MrunalSwaroop/deskbot/versions/v0.0.5.4/README.md

# Deskbot v0.0.5.4

**Purpose:** Phone-first dashboard and deferred OTA startup check.

- **Source commit:** `522c56ab17a76cb1aa1095f2c555ba99d42b39a4`
- **Buildable source:** [`source/`](source/)
- **GitHub Release:** [v0.0.5.4](https://github.com/MrunalSwaroop/deskbot/releases/tag/v0.0.5.4)
- **OTA firmware asset:** [v0.0.5.4 binary](https://github.com/MrunalSwaroop/deskbot/releases/download/v0.0.5.4/XIAO-ESP32S3.bin)
- **OTA manifest:** [v0.0.5.4 manifest](https://MrunalSwaroop.github.io/deskbot/releases/0.0.5.4/manifest.json)

The `source/` directory is a historical source snapshot. Build outputs, local `ota_target.h`, Wi-Fi passwords, API keys, and other credentials are intentionally excluded.
