MrunalSwaroop/deskbot/versions/v0.0.5.4/source/modules/audio/README.md

# Audio Module

The current MAX98357A implementation provides the verified I2S initialization and low-volume tone test in `firmware/xiao_esp32s3_sense/xiao_esp32s3_sense.ino`. The next extraction should move PCM playback, tone generation, volume limits, and audio-state events here.

The module must preserve GPIO2/D1 data, GPIO3/D2 BCLK, GPIO4/D3 LRCK, the onboard PDM microphone reservation, and the bridge-tied speaker-output warning.

## v0.0.5.2 loopback boundary

`mic_loopback.h` defines the bounded microphone-to-speaker test policy. The integration sketch owns the I2S objects, applies software volume, and stops loopback automatically. Keep this separate from future decoded speech playback.
