MrunalSwaroop/deskbot/V.0.0.2/legacy/README.md

# Legacy Experiments

This directory contains the historical UNO R4, generic ESP32, laptop bridge, and early face prototypes. They are retained for reference only.

The active Deskbot controller is the XIAO ESP32-S3 Sense firmware under `firmware/xiao_esp32s3_sense/`. Do not include legacy sketches in the active XIAO build or OTA artifact.
