MrunalSwaroop/deskbot/versions/v0.0.1/README.md

# Deskbot v0.0.1

**Purpose:** Frozen XIAO ESP32-S3 Sense hardware baseline.

- **Source commit:** `07578cf026eb161585037c67768f1b4a59ac9450`
- **Buildable source:** [`source/`](source/)
- **GitHub Release:** [v0.0.1](https://github.com/MrunalSwaroop/deskbot/releases/tag/v0.0.1)
- **OTA firmware asset:** [v0.0.1 binary](https://github.com/MrunalSwaroop/deskbot/releases/download/v0.0.1/XIAO-ESP32S3.bin)
- **OTA manifest:** [v0.0.1 manifest](https://MrunalSwaroop.github.io/deskbot/releases/0.0.1/manifest.json)

The `source/` directory is a historical source snapshot. Build outputs, local `ota_target.h`, Wi-Fi passwords, API keys, and other credentials are intentionally excluded.
