MrunalSwaroop/deskbot/versions/v0.0.4/README.md

# Deskbot v0.0.4

**Purpose:** OTA-stable ESP32 Arduino core 3.3.7 baseline.

- **Source commit:** `9120a983b3ed8a17bfb8108c6694ef7dbb7d3194`
- **Buildable source:** [`source/`](source/)
- **GitHub Release:** [v0.0.4](https://github.com/MrunalSwaroop/deskbot/releases/tag/v0.0.4)
- **OTA firmware asset:** [v0.0.4 binary](https://github.com/MrunalSwaroop/deskbot/releases/download/v0.0.4/XIAO-ESP32S3.bin)
- **OTA manifest:** [v0.0.4 manifest](https://MrunalSwaroop.github.io/deskbot/releases/0.0.4/manifest.json)

The `source/` directory is a historical source snapshot. Build outputs, local `ota_target.h`, Wi-Fi passwords, API keys, and other credentials are intentionally excluded.
