MrunalSwaroop/deskbot/versions/v0.0.5.1/README.md

# Deskbot v0.0.5.1

**Purpose:** OLED inversion and OTA state/progress UI.

- **Source commit:** `f95edb852325a56a45b004a5ab532f8c2b33f6a1`
- **Buildable source:** [`source/`](source/)
- **GitHub Release:** [v0.0.5.1](https://github.com/MrunalSwaroop/deskbot/releases/tag/v0.0.5.1)
- **OTA firmware asset:** [v0.0.5.1 binary](https://github.com/MrunalSwaroop/deskbot/releases/download/v0.0.5.1/XIAO-ESP32S3.bin)
- **OTA manifest:** [v0.0.5.1 manifest](https://MrunalSwaroop.github.io/deskbot/releases/0.0.5.1/manifest.json)

The `source/` directory is a historical source snapshot. Build outputs, local `ota_target.h`, Wi-Fi passwords, API keys, and other credentials are intentionally excluded.
