MrunalSwaroop/deskbot/versions/v0.0.5.2/README.md

# Deskbot v0.0.5.2

**Purpose:** Microphone loopback, speaker volume, and wake-name boundary.

- **Source commit:** `c314447c3eacd343f680d7743e713bf62445ca13`
- **Buildable source:** [`source/`](source/)
- **GitHub Release:** [v0.0.5.2](https://github.com/MrunalSwaroop/deskbot/releases/tag/v0.0.5.2)
- **OTA firmware asset:** [v0.0.5.2 binary](https://github.com/MrunalSwaroop/deskbot/releases/download/v0.0.5.2/XIAO-ESP32S3.bin)
- **OTA manifest:** [v0.0.5.2 manifest](https://MrunalSwaroop.github.io/deskbot/releases/0.0.5.2/manifest.json)

The `source/` directory is a historical source snapshot. Build outputs, local `ota_target.h`, Wi-Fi passwords, API keys, and other credentials are intentionally excluded.
