MrunalSwaroop/deskbot/versions/v0.0.5.3/README.md

# Deskbot v0.0.5.3

**Purpose:** Dual Wi-Fi, setup fallback, remote OLED, and versioned OTA catalog.

- **Source commit:** `5d226d0db5bbb8b0b62f9164e7e145dcdf0be262`
- **Buildable source:** [`source/`](source/)
- **GitHub Release:** [v0.0.5.3](https://github.com/MrunalSwaroop/deskbot/releases/tag/v0.0.5.3)
- **OTA firmware asset:** [v0.0.5.3 binary](https://github.com/MrunalSwaroop/deskbot/releases/download/v0.0.5.3/XIAO-ESP32S3.bin)
- **OTA manifest:** [v0.0.5.3 manifest](https://MrunalSwaroop.github.io/deskbot/releases/0.0.5.3/manifest.json)

The `source/` directory is a historical source snapshot. Build outputs, local `ota_target.h`, Wi-Fi passwords, API keys, and other credentials are intentionally excluded.
