MrunalSwaroop/deskbot/versions/v0.0.5.4/source/hardware/wiring/assembly_layout.png

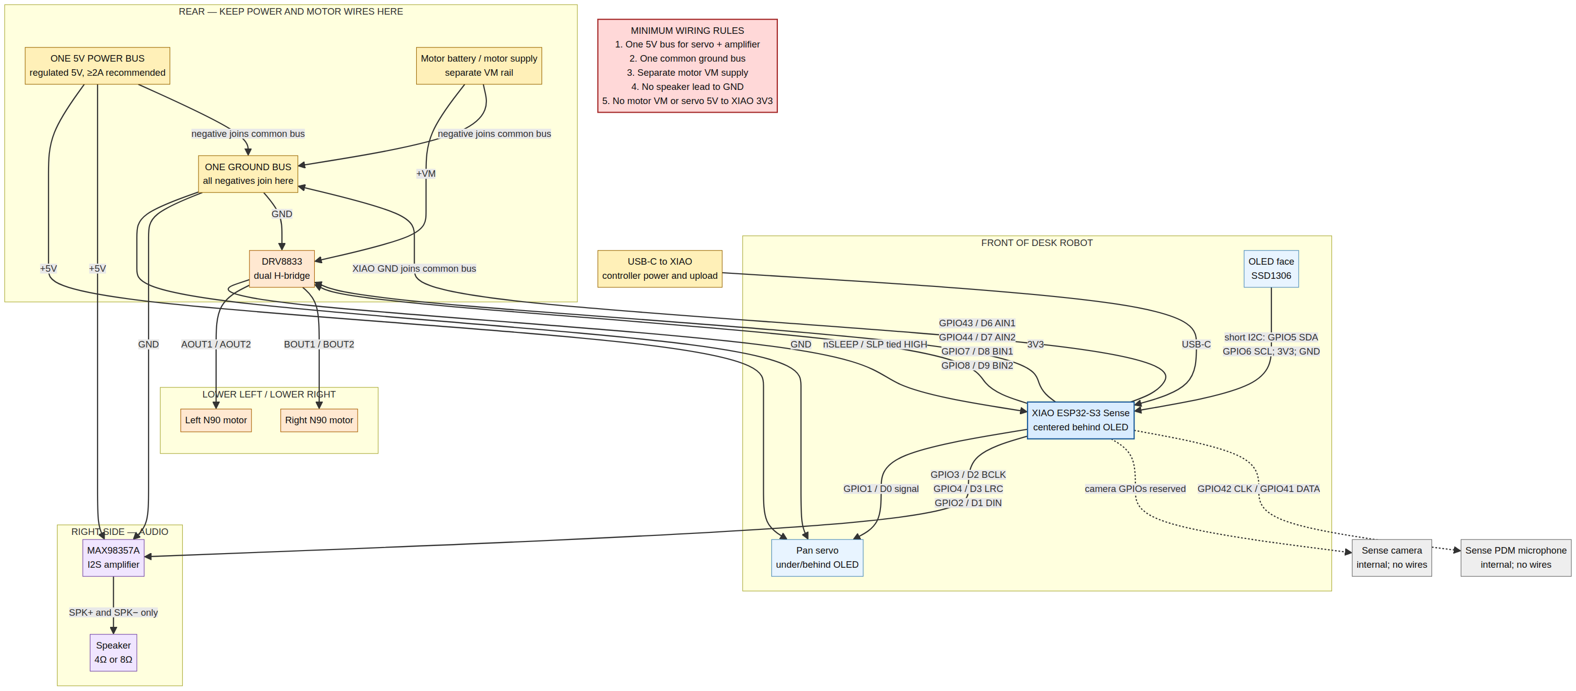
versions/v0.0.5.4/source/hardware/wiring/assembly_layout.png
