MrunalSwaroop/deskbot/versions/v0.0.5.4/source/hardware/wiring/complete_wiring.png

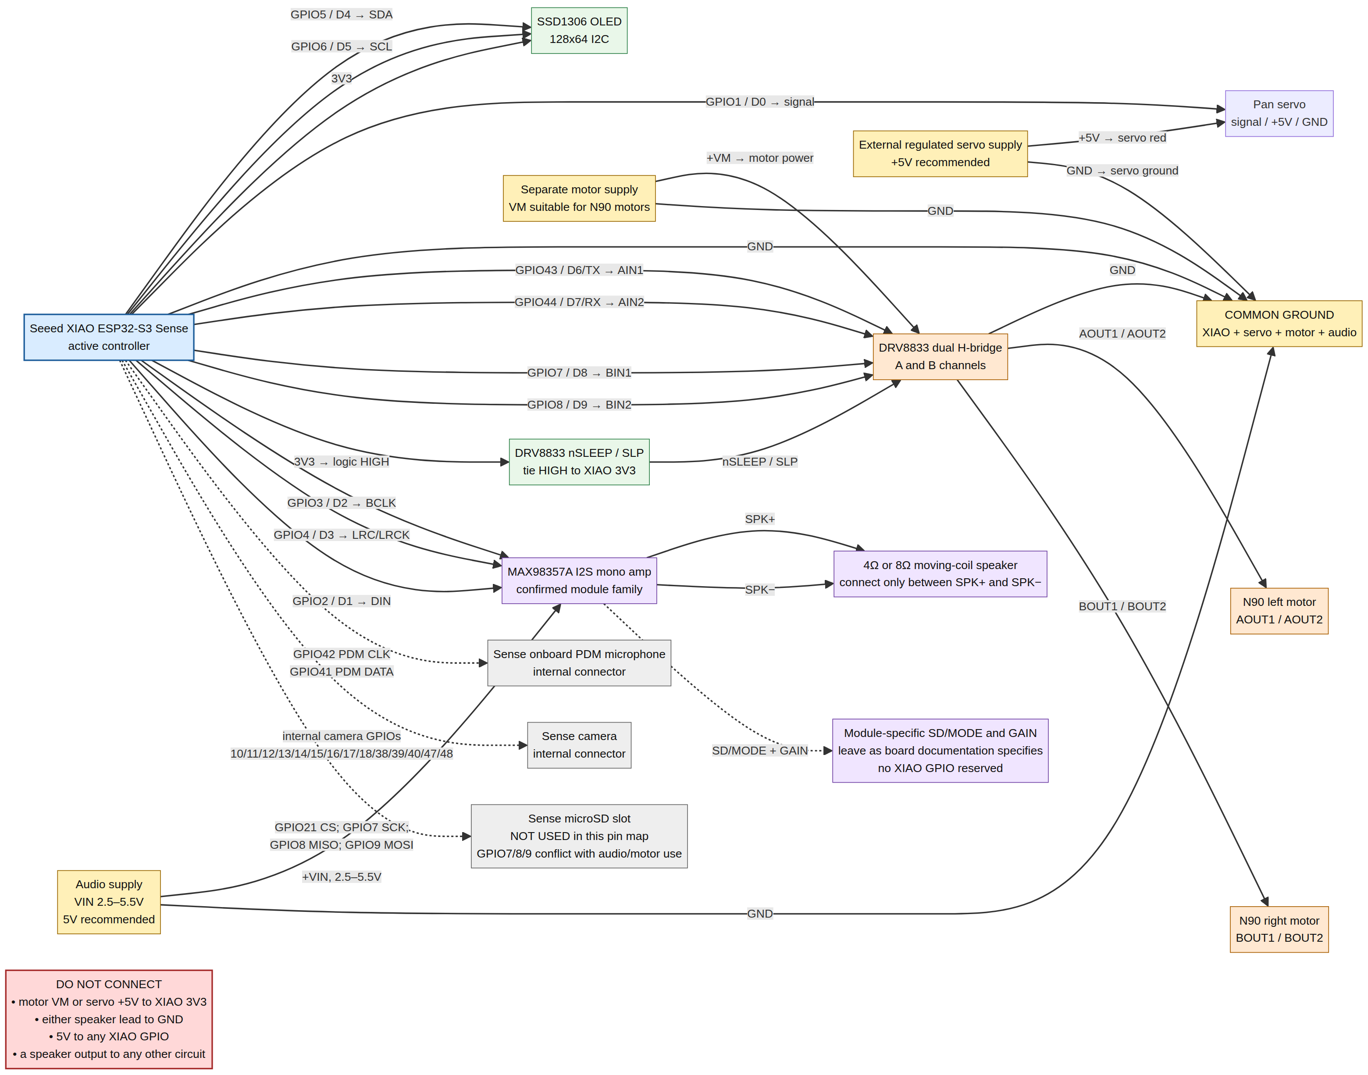
versions/v0.0.5.4/source/hardware/wiring/complete_wiring.png
