MrunalSwaroop/deskbot/versions/v0.0.5.4/source/firmware/xiao_esp32s3_sense/xiao_esp32s3_sense.ino

#include <WiFi.h>
#include <WebServer.h>
#include <Preferences.h>
#include <Wire.h>
#include <Adafruit_GFX.h>
#include <Adafruit_SSD1306.h>
#include <ESP32Servo.h>
#include <ESP_I2S.h>
#include <time.h>
#include <esp_camera.h>
#include "../../boards/xiao-esp32s3-sense/pinmap.h"
#include "device_config.h"
#include "ota_service.h"
#include "../../modules/core/face_state.h"
#include "../../modules/core/personality.h"
#include "../../modules/audio/mic_loopback.h"
#include "../../modules/voice/wake_name.h"
#include "../../modules/network/wifi_profiles.h"
#include "../../modules/ota/version_catalog.h"
#include "../../modules/core/release_notes.h"

/*
  Rocky XIAO Desk Buddy - modular Stage 2 bring-up

  This firmware is intentionally a hardware bring-up base, not the final voice
  firmware. It tests one function at a time:
    OLED -> servo -> DRV8833/N90 motors -> Wi-Fi/dashboard.

  Hardware-specific choices live in boards/xiao-esp32s3-sense/pinmap.h. No Wi-Fi password or API key
  is compiled into this sketch; Wi-Fi is provisioned through the setup AP.

  DRV8833 control model:
    AIN1/AIN2 control the left motor; BIN1/BIN2 control the right motor.
    PWM is applied directly to the selected input and the opposite input is LOW.
    nSLEEP/SLP must be tied to XIAO 3V3. nFAULT is optional and not used here.
*/

#define SCREEN_WIDTH 128
#define SCREEN_HEIGHT 64

Adafruit_SSD1306 display(SCREEN_WIDTH, SCREEN_HEIGHT, &Wire, -1);
#include "../../modules/faces/isabella_character.h"
#include "../../modules/faces/spartan_character.h"
#include "../../modules/faces/rocky_body_language.h"
namespace RockyBodyLanguage {
Adafruit_SSD1306 &display = ::display;
}
WebServer server(80);
Preferences preferences;
Servo headServo;
I2SClass microphone;
I2SClass audioOutput;
OtaService otaService;

// ------------------------------ State ------------------------------

FaceMode faceMode = FACE_IDLE;
Personality personality = PERSONALITY_CALM;
int panAngle = 90;
int motorSpeed = ROCKY_DEFAULT_MOTOR_SPEED;
String lastEvent = "Booting";
String lastCommand = "none";
String savedSsid;
String savedPassword;
String savedSsid2;
String savedPassword2;
WifiProfile wifiProfiles[2];
int activeWifiIndex = -1;

bool provisioningAP = false;
unsigned long lastWiFiAttempt = 0;
unsigned long wifiUnavailableSince = 0;
unsigned long apStartedAt = 0;
const unsigned long WIFI_FALLBACK_AP_AFTER_MS = 300000UL;
unsigned long lastMotorCommand = 0;
unsigned long lastFaceFrame = 0;
unsigned long faceFrame = 0;
unsigned long nextIsabellaMoodAt = 0;
FaceMode isabellaMood = FACE_IDLE;
bool importedCharacterStateOverride = false;
bool cameraReady = false;
bool cameraBusy = false;
bool microphoneReady = false;
bool microphoneMonitor = false;
bool microphoneLoopback = false;
bool audioReady = false;
bool audioToneActive = false;
bool headFollowsState = true;
bool danceActive = false;
bool liveCameraActive = false;
bool oledInverted = false;
String otaUiState = "idle";
int otaUiProgress = 0;
bool rockyCharacterStateOverride = false;
bool leftMotorInvert = ROCKY_LEFT_MOTOR_INVERT;
bool rightMotorInvert = ROCKY_RIGHT_MOTOR_INVERT;
unsigned long microphoneMonitorUntil = 0;
unsigned long microphoneLoopbackUntil = 0;
unsigned long lastMicRead = 0;
unsigned long lastMicPrint = 0;
int microphoneLevel = 0;
int speakerVolume = 20;
String wakeName = "rocky";
bool wakeNameEnabled = true;
bool wakeNameEngaged = false;
unsigned long wakeEngagedUntil = 0;
unsigned long audioToneUntil = 0;
uint32_t audioTonePhase = 0;
uint32_t audioTonePhaseStep = 0;
int audioToneFrequency = 440;
int danceStep = 0;
unsigned long danceStepStarted = 0;

// ------------------------------ Declarations ------------------------------

void drawFace();
void syncImportedCharacterState();
bool drawImportedCharacter();
void drawEyes(int eyeY, int eyeH, bool narrow, bool round, bool lookingLeft, bool lookingRight);
void drawMouth();
void drawWiFiIndicator();
void drawOtaIndicator();
void onOtaUiEvent(const char *state, int progress);
void setOledInverted(bool enabled, const String &reason);
void drawPersonalityAccent();
void updateIsabellaMood();
void updateMicrophone();
void updateAudioTone();
void startMicLoopback(uint32_t durationMs);
void stopMicLoopback(const String &reason);
void setSpeakerVolume(int percent);
void engageWakeName(const String &source);
void drawMicIndicator();
void updateDance();
void applyStateHeadPose();
void startDance();
void stopDance(const String &reason);
void setFace(FaceMode mode, const String &eventText);
void setPersonality(const String &name);
void processSerialCommand(const String &command);
void runTest(const String &name);
void runMotorChannelTest(const String &side);
void setPan(int angle);
void stopMotors(const String &reason);
void driveMotors(const String &direction, int speed, uint32_t durationMs);
void setMotorChannel(int in1, int in2, int signedPwm, bool invert);
void startAccessPoint();
void connectStoredWiFi();
bool tryWiFiProfiles();
void maintainWiFi();
void setupRoutes();
void handleRoot();
void handleHealth();
void handleStatus();
void handleChanges();
void handleCommand();
void handleOledSvg();
void handleOtaCatalog();
void handleCameraJpg();
void handleCameraLive();
void handleWiFiForm();
void handleWiFiSave();
void handleNotFound();
String pageHeader(const String &title);
String htmlEscape(const String &value);
String faceName();
String personalityName();
String networkModeName();
String currentTimeText();
String motorDriverName();
String cameraStatusName();
bool initCamera();
bool initMicrophone();
String microphoneStatusName();
bool initAudio();
String audioStatusName();
void startAudioTone(int frequency, uint32_t durationMs);
void stopAudio(const String &reason);

// ------------------------------ Setup/loop ------------------------------

void setup() {
  Serial.begin(115200);
  delay(500);
  randomSeed((uint32_t)micros());

  Wire.begin(ROCKY_OLED_SDA, ROCKY_OLED_SCL);
  if (!display.begin(SSD1306_SWITCHCAPVCC, ROCKY_OLED_ADDRESS)) {
    Serial.println("OLED ERROR: check VCC/GND, SDA/SCL, address 0x3C or 0x3D");
  } else {
    display.clearDisplay();
    display.setTextColor(SSD1306_WHITE);
    display.setTextSize(1);
    display.setCursor(8, 20);
    display.println("Rocky XIAO booting");
    display.display();
  }

  // Servo signal only: use an external regulated 5 V servo supply and common GND.
  headServo.setPeriodHertz(50);
  headServo.attach(ROCKY_SERVO_PIN, 500, 2400);
  setPan(90);

  // DRV8833 has no separate enable pins. All four input pins are outputs.
  pinMode(ROCKY_LEFT_IN1, OUTPUT);
  pinMode(ROCKY_LEFT_IN2, OUTPUT);
  pinMode(ROCKY_RIGHT_IN1, OUTPUT);
  pinMode(ROCKY_RIGHT_IN2, OUTPUT);
  stopMotors("Boot safety stop");

  cameraReady = initCamera();
  microphoneReady = initMicrophone();
  audioReady = initAudio();

  preferences.begin("rocky-xiao", false);
  savedSsid = preferences.getString("ssid", "");
  savedPassword = preferences.getString("pass", "");
  savedSsid2 = preferences.getString("ssid2", "");
  savedPassword2 = preferences.getString("pass2", "");
  wifiProfiles[0] = {savedSsid, savedPassword};
  wifiProfiles[1] = {savedSsid2, savedPassword2};
  leftMotorInvert = preferences.getBool("leftInv", ROCKY_LEFT_MOTOR_INVERT);
  rightMotorInvert = preferences.getBool("rightInv", ROCKY_RIGHT_MOTOR_INVERT);
  oledInverted = preferences.getBool("oledInv", false);
  speakerVolume = constrain((int)preferences.getUChar("spkVol", 20), 0, 100);
  wakeName = preferences.getString("wakeName", "rocky");
  if (wakeName.length() == 0) wakeName = "rocky";
  wakeNameEnabled = preferences.getBool("wakeEnabled", true);
  display.invertDisplay(oledInverted);

  setupRoutes();
  // Network must exist before WebServer::begin() on recent ESP32 cores.
  connectStoredWiFi();
  server.begin();
  configTime(ROCKY_DEFAULT_TIMEZONE_OFFSET_SECONDS, 0, "pool.ntp.org", "time.nist.gov");
  otaService.setUiCallback(onOtaUiEvent);
  otaService.begin();

  setFace(FACE_IDLE, "Ready");
  nextIsabellaMoodAt = millis() + ROCKY_ISABELLA_MOOD_MIN_MS;

  Serial.println();
  Serial.println("Rocky XIAO modular bring-up ready");
  Serial.println("Hardware config: boards/xiao-esp32s3-sense/pinmap.h");
  Serial.println("Driver: DRV8833 direct-input PWM");
  Serial.println("Commands: help, status, test oled/servo/motor/left/right/wifi/camera/mic/audio");
  Serial.println("          face idle/listening/thinking/working/speaking/happy/laugh/curious/sad/surprised/error/sleep");
  Serial.println("          personality calm/rocky/engineer/spartan/isabella");
  Serial.println("          isabella neutral/shy/happy/concerned/listening/speaking/sleeping");
  Serial.println("          spartan guard/command/salute/listening/thinking/laughing/march/attack/victory/sleeping");
  Serial.println("          pan 0..180, head auto/on/off, motor forward/back/left/right/test/stop");
  Serial.println("          motor speed 0..255, motor invert left/right on/off, dance start/stop, mic monitor");
  Serial.println("          audio tone [Hz] [ms], audio volume 0..100, audio stop");
  Serial.println("          mic loopback [seconds], mic monitor, mic off");
  Serial.println("          wake name <name>, wake on/off, wake simulate");
  Serial.println("          oled invert on/off/toggle");
  Serial.println("          wifi profiles: two saved 2.4 GHz networks; AP fallback after 5 minutes");
  Serial.println("          ota latest | ota target <version> | ota clear");
}

void loop() {
  server.handleClient();
  maintainWiFi();
  otaService.update();

  if (millis() - lastMotorCommand > ROCKY_MOTOR_COMMAND_TIMEOUT_MS) {
    stopMotors("Motor timeout safety stop");
  }

  if (personality == PERSONALITY_ISABELLA) updateIsabellaMood();
  updateMicrophone();
  updateAudioTone();
  if (wakeNameEngaged && millis() >= wakeEngagedUntil) {
    wakeNameEngaged = false;
    if (!microphoneLoopback && faceMode == FACE_LISTENING) setFace(FACE_IDLE, "Wake interaction timeout");
  }
  updateDance();

  if (millis() - lastFaceFrame >= ROCKY_FACE_FRAME_MS) {
    lastFaceFrame = millis();
    faceFrame++;
    if (personality == PERSONALITY_ROCKY) RockyBodyLanguage::tickIntegration(millis());
    drawFace();
  }

  if (Serial.available()) {
    String command = Serial.readStringUntil('\n');
    command.trim();
    if (command.length() > 0) processSerialCommand(command);
  }
}

// ------------------------------ Command layer ------------------------------

void processSerialCommand(const String &command) {
  if (command.length() == 0) return;
  lastCommand = command;

  String lower = command;
  lower.toLowerCase();

  if (lower == "help") {
    Serial.println("test oled | test servo | test motor | test left | test right | test wifi | test camera | test mic | test audio");
    Serial.println("face idle|listening|thinking|speaking|working|happy|laugh|curious|sad|surprised|error|sleep");
    Serial.println("personality calm|rocky|engineer|spartan|isabella");
    Serial.println("rocky [idle|curious|greeting|listening|forward|back|pace|come|go|sleep|wake|dance]");
    Serial.println("isabella <state> | spartan <state>");
    Serial.println("pan 0..180");
    Serial.println("motor forward|back|left|right|test|stop");
    Serial.println("motor speed 0..255");
    Serial.println("motor invert left/right on/off | head auto/on/off | dance start/stop | mic monitor");
    Serial.println("mic loopback [seconds] | mic off | audio volume 0..100");
    Serial.println("audio tone [Hz] [ms] | audio stop");
    Serial.println("wake name <name> | wake on/off | wake simulate");
    Serial.println("restart (reboot and check OTA manifest)");
    Serial.println("status");
    return;
  }

  if (lower == "restart" || lower == "reboot") {
    Serial.println("Restarting Deskbot; OTA-enabled builds will check GitHub Pages at boot");
    delay(250);
    ESP.restart();
    return;
  }

  if (lower.startsWith("test ")) {
    runTest(lower.substring(5));
    return;
  }

  if (lower == "status") {
    Serial.println("--- XIAO STATUS ---");
    Serial.print("Network: "); Serial.println(networkModeName());
    Serial.print("IP: "); Serial.println(provisioningAP ? WiFi.softAPIP() : WiFi.localIP());
    Serial.print("RSSI: "); Serial.println(provisioningAP ? 0 : WiFi.RSSI());
    Serial.print("Face: "); Serial.println(faceName());
    Serial.print("Personality: "); Serial.println(personalityName());
    Serial.print("Pan: "); Serial.println(panAngle);
    Serial.print("Motor driver: "); Serial.println(motorDriverName());
    Serial.print("Motor speed: "); Serial.println(motorSpeed);
    Serial.print("Camera: "); Serial.println(cameraStatusName());
    Serial.print("Microphone: "); Serial.println(microphoneStatusName());
    Serial.print("Mic level: "); Serial.println(microphoneLevel);
    Serial.print("Audio: "); Serial.println(audioStatusName());
    Serial.print("Head follows state: "); Serial.println(headFollowsState ? "on" : "off");
    Serial.print("Dance: "); Serial.println(danceActive ? "active" : "off");
    Serial.print("Motor invert L/R: "); Serial.print(leftMotorInvert); Serial.print("/"); Serial.println(rightMotorInvert);
    Serial.print("OLED invert: "); Serial.println(oledInverted ? "on" : "off");
    Serial.print("OTA state: "); Serial.println(otaService.stateName());
    Serial.print("OTA remote version: "); Serial.println(otaService.remoteVersion());
    Serial.print("OTA progress: "); Serial.print(otaService.progress()); Serial.println("%");
    Serial.print("Board ID: "); Serial.println(otaService.boardId());
    Serial.print("Firmware: "); Serial.println(APP_VERSION);
    Serial.println("OTA: checked once at boot; requires ota_target.h and a published newer manifest");
    Serial.print("Last event: "); Serial.println(lastEvent);
    return;
  }

  if (lower.startsWith("face ")) {
    String value = lower.substring(5);
    if (value == "idle") setFace(FACE_IDLE, "Face idle");
    else if (value == "listening") setFace(FACE_LISTENING, "Listening");
    else if (value == "thinking") setFace(FACE_THINKING, "Thinking");
    else if (value == "speaking") setFace(FACE_SPEAKING, "Speaking");
    else if (value == "working") setFace(FACE_WORKING, "Executing");
    else if (value == "happy") setFace(FACE_HAPPY, "Happy");
    else if (value == "laugh") setFace(FACE_LAUGH, "Laughing");
    else if (value == "curious") setFace(FACE_CURIOUS, "Curious");
    else if (value == "sad") setFace(FACE_SAD, "Sad");
    else if (value == "surprised") setFace(FACE_SURPRISED, "Surprised");
    else if (value == "error") setFace(FACE_ERROR, "Error");
    else if (value == "sleep") setFace(FACE_SLEEP, "Sleeping");
    else Serial.println("Unknown face");
    return;
  }

  if (lower.startsWith("personality ")) {
    setPersonality(lower.substring(12));
    return;
  }

  if (lower == "rocky") {
    setPersonality("rocky");
    return;
  }
  if (lower.startsWith("rocky ")) {
    setPersonality("rocky");
    const String rockyState = lower.substring(6);
    RockyBodyLanguage::BodyState targetState;
    if (RockyBodyLanguage::bodyStateFromName(rockyState, targetState)) {
      RockyBodyLanguage::setIntegrationState(rockyState);
      rockyCharacterStateOverride = true;
      lastEvent = String("Rocky body state: ") + RockyBodyLanguage::stateName();
      Serial.println(lastEvent);
      drawFace();
    } else {
      Serial.println("Rocky states: idle, curious, greeting, listening, forward, back, pace, come, go, sleep, wake, dance");
    }
    return;
  }

  if (lower == "isabella") {
    setPersonality("isabella");
    return;
  }
  if (lower.startsWith("isabella ")) {
    setPersonality("isabella");
    const String stateName = lower.substring(9);
    if (setIsabellaStateByName(stateName)) {
      importedCharacterStateOverride = true;
      lastEvent = "Isabella state: " + stateName;
      drawFace();
    } else {
      printIsabellaHelp();
    }
    return;
  }
  if (lower == "spartan") {
    setPersonality("spartan");
    return;
  }
  if (lower.startsWith("spartan ")) {
    setPersonality("spartan");
    const String stateName = lower.substring(8);
    if (setSpartanStateByName(stateName)) {
      importedCharacterStateOverride = true;
      lastEvent = "Spartan state: " + stateName;
      drawFace();
    } else {
      printSpartanHelp();
    }
    return;
  }

  if (lower == "ota latest" || lower == "ota clear") {
    otaService.clearTargetVersion();
    lastEvent = "OTA target cleared; latest release selected";
    Serial.println(lastEvent);
    return;
  }
  if (lower.startsWith("ota target ")) {
    String target = lower.substring(11);
    target.trim();
    if (otaService.setTargetVersion(target)) {
      lastEvent = "OTA target selected: " + target;
      Serial.println(lastEvent);
    } else {
      Serial.println("OTA target must use a four-part version such as 0.0.5.2");
    }
    return;
  }

  if (lower.startsWith("oled invert")) {
    String value = lower.substring(11);
    value.trim();
    if (value == "toggle") setOledInverted(!oledInverted, "OLED invert toggled");
    else if (value == "on" || value == "1" || value == "true") setOledInverted(true, "OLED inverted");
    else if (value == "off" || value == "0" || value == "false") setOledInverted(false, "OLED normal");
    else Serial.println("Use: oled invert on/off/toggle");
    return;
  }
  if (lower.startsWith("wake name ")) {
    String value = command.substring(10);
    value.trim();
    if (value.length() < 2 || value.length() > 20) {
      Serial.println("Wake name must be 2..20 characters");
    } else {
      wakeName = value;
      preferences.putString("wakeName", wakeName);
      lastEvent = "Wake name set: " + wakeName;
      Serial.println(lastEvent);
    }
    return;
  }
  if (lower == "wake on" || lower == "wake enable") {
    wakeNameEnabled = true;
    preferences.putBool("wakeEnabled", true);
    lastEvent = "Wake name enabled: " + wakeName;
    Serial.println(lastEvent);
    return;
  }
  if (lower == "wake off" || lower == "wake disable") {
    wakeNameEnabled = false;
    preferences.putBool("wakeEnabled", false);
    lastEvent = "Wake name disabled";
    Serial.println(lastEvent);
    return;
  }
  if (lower == "wake simulate" || lower == "engage") {
    engageWakeName("manual test");
    return;
  }
  if (lower.startsWith("audio volume ")) {
    setSpeakerVolume(constrain(lower.substring(13).toInt(), 0, 100));
    return;
  }
  if (lower.startsWith("mic loopback")) {
    String args = lower.substring(12);
    args.trim();
    int seconds = args.length() ? args.toInt() : 60;
    if (seconds <= 0) seconds = 60;
    startMicLoopback(constrain(seconds, 1, 300) * 1000UL);
    return;
  }

  if (lower.startsWith("pan ")) {
    setPan(constrain(lower.substring(4).toInt(), ROCKY_SERVO_MIN_ANGLE, ROCKY_SERVO_MAX_ANGLE));
    return;
  }

  if (lower.startsWith("motor speed ")) {
    motorSpeed = constrain(lower.substring(12).toInt(), 0, 255);
    lastEvent = "Motor speed " + String(motorSpeed);
    Serial.println(lastEvent);
    return;
  }

  if (lower.startsWith("motor invert ")) {
    String value = lower.substring(13);
    int split = value.indexOf(' ');
    if (split < 0) {
      Serial.println("Use: motor invert left/right on/off");
      return;
    }
    String side = value.substring(0, split);
    String setting = value.substring(split + 1);
    bool enabled = (setting == "on" || setting == "1" || setting == "true");
    if (side == "left") {
      leftMotorInvert = enabled;
      preferences.putBool("leftInv", leftMotorInvert);
    } else if (side == "right") {
      rightMotorInvert = enabled;
      preferences.putBool("rightInv", rightMotorInvert);
    } else {
      Serial.println("Use left or right");
      return;
    }
    lastEvent = "Motor invert " + side + " " + (enabled ? "on" : "off");
    Serial.println(lastEvent);
    return;
  }

  if (lower == "head auto" || lower == "head on") {
    headFollowsState = true;
    lastEvent = "Head follows interaction state";
    Serial.println(lastEvent);
    return;
  }
  if (lower == "head off") {
    headFollowsState = false;
    lastEvent = "Head state following off";
    Serial.println(lastEvent);
    return;
  }
  if (lower == "dance start" || lower == "dance rocky" || lower == "dance isabella") {
    startDance();
    return;
  }
  if (lower == "dance stop") {
    stopDance("Dance stopped");
    return;
  }
  if (lower == "mic monitor" || lower == "mic on") {
    microphoneMonitor = true;
    microphoneLoopback = false;
    microphoneMonitorUntil = millis() + 60000UL;
    setFace(FACE_LISTENING, "Microphone monitor");
    Serial.println("Microphone level monitor active for 60 seconds; no speaker output");
    return;
  }
  if (lower == "mic off") {
    stopMicLoopback("Microphone off");
    microphoneMonitor = false;
    microphoneLevel = 0;
    setFace(FACE_IDLE, "Microphone monitor off");
    return;
  }

  if (lower == "audio stop") {
    stopAudio("Audio stopped");
    return;
  }

  if (lower.startsWith("audio tone")) {
    String args = lower.substring(10);
    args.trim();
    int split = args.indexOf(' ');
    int frequency = split < 0 ? args.toInt() : args.substring(0, split).toInt();
    int duration = split < 0 ? 1500 : args.substring(split + 1).toInt();
    if (frequency <= 0) frequency = 440;
    if (duration <= 0) duration = 1500;
    startAudioTone(constrain(frequency, 100, 4000), constrain(duration, 100, 10000));
    return;
  }

  if (lower == "motor forward") driveMotors("forward", motorSpeed, 700);
  else if (lower == "motor back") driveMotors("back", motorSpeed, 700);
  else if (lower == "motor left") driveMotors("left", motorSpeed, 500);
  else if (lower == "motor right") driveMotors("right", motorSpeed, 500);
  else if (lower == "motor test") runTest("motor");
  else if (lower == "motor stop") stopMotors("Manual motor stop");
  else Serial.println("Unknown command; type help");
}

void runTest(const String &name) {
  if (name == "oled") {
    Serial.println("TEST OLED: cycling face states");
    setFace(FACE_HAPPY, "OLED test happy");
    delay(500);
    setFace(FACE_THINKING, "OLED test thinking");
    delay(700);
    setFace(FACE_WORKING, "OLED test working");
    delay(700);
    setFace(FACE_SPEAKING, "OLED test speaking");
    delay(700);
    setFace(FACE_IDLE, "OLED test complete");
    return;
  }
  if (name == "servo") {
    Serial.println("TEST SERVO: 90 -> 60 -> 120 -> 90");
    setPan(90); delay(400);
    setPan(60); delay(500);
    setPan(120); delay(500);
    setPan(90);
    return;
  }
  if (name == "motor") {
    Serial.println("TEST MOTOR: forward then stop; keep robot lifted");
    driveMotors("forward", motorSpeed, 500);
    delay(650);
    stopMotors("Motor test complete");
    return;
  }
  if (name == "left" || name == "right") {
    runMotorChannelTest(name);
    return;
  }
  if (name == "wifi") {
    Serial.print("Wi-Fi: "); Serial.println(networkModeName());
    Serial.print("IP: "); Serial.println(provisioningAP ? WiFi.softAPIP() : WiFi.localIP());
    Serial.print("RSSI: "); Serial.println(provisioningAP ? 0 : WiFi.RSSI());
    return;
  }
  if (name == "camera") {
    Serial.print("Camera: "); Serial.println(cameraStatusName());
    Serial.println(cameraReady ? "Open /camera.jpg from the dashboard device IP" : "Camera is not initialized");
    return;
  }
  if (name == "mic") {
    if (!microphoneReady) {
      Serial.println("MIC ERROR: microphone is not initialized");
      return;
    }
    startMicLoopback(60000UL);
    Serial.println("MIC TEST: speak near the Sense microphone; audio is routed to the speaker for 60 seconds");
    return;
  }
  if (name == "audio") {
    if (!audioReady) {
      Serial.println("AUDIO ERROR: MAX98357A I2S output is not initialized");
      return;
    }
    Serial.println("AUDIO TEST: 440 Hz tone for 1.5 seconds; start with low volume");
    startAudioTone(440, 1500);
    return;
  }
  Serial.println("Unknown test. Use: test oled, test servo, test motor, test left, test right, test wifi, test camera, test mic, test audio");
}

void runMotorChannelTest(const String &side) {
  Serial.print("TEST MOTOR CHANNEL: "); Serial.println(side);
  Serial.println("Keep the robot lifted. This runs only one N90 for 400 ms.");
  if (side == "left") {
    setMotorChannel(ROCKY_LEFT_IN1, ROCKY_LEFT_IN2, motorSpeed, leftMotorInvert);
  } else {
    setMotorChannel(ROCKY_RIGHT_IN1, ROCKY_RIGHT_IN2, motorSpeed, rightMotorInvert);
  }
  delay(400);
  stopMotors("Single motor channel test complete");
}

void setFace(FaceMode mode, const String &eventText) {
  faceMode = mode;
  importedCharacterStateOverride = false;
  rockyCharacterStateOverride = false;
  lastEvent = eventText;
  if (personality == PERSONALITY_ISABELLA && mode == FACE_IDLE) isabellaMood = FACE_IDLE;
  applyStateHeadPose();
  Serial.print("FACE: "); Serial.println(eventText);
  drawFace();
}

void setPersonality(const String &name) {
  String value = name;
  value.toLowerCase();
  if (value == "calm") personality = PERSONALITY_CALM;
  else if (value == "rocky" || value == "musical") personality = PERSONALITY_ROCKY;
  else if (value == "engineer") personality = PERSONALITY_ENGINEER;
  else if (value == "spartan") personality = PERSONALITY_SPARTAN;
  else if (value == "isabella" || value == "jolly" || value == "anime") personality = PERSONALITY_ISABELLA;
  else {
    Serial.println("Unknown personality; use calm, rocky, engineer, spartan, or isabella");
    return;
  }

  isabellaMood = FACE_IDLE;
  importedCharacterStateOverride = false;
  rockyCharacterStateOverride = false;
  nextIsabellaMoodAt = millis() + ROCKY_ISABELLA_MOOD_MIN_MS;
  if (personality == PERSONALITY_ROCKY) {
    RockyBodyLanguage::rockyPersonality = true;
    RockyBodyLanguage::playing = true;
    RockyBodyLanguage::setIntegrationState("idle");
  } else {
    RockyBodyLanguage::rockyPersonality = false;
  }
  lastEvent = "Personality: " + personalityName();
  Serial.println(lastEvent);
  drawFace();
}

void syncImportedCharacterState() {
  if (personality == PERSONALITY_ISABELLA) {
    if (importedCharacterStateOverride) {
      isabellaFrame = static_cast<uint8_t>(faceFrame);
      return;
    }
    IsabellaState target = ISABELLA_NEUTRAL;
    switch (faceMode) {
      case FACE_LISTENING: target = ISABELLA_LISTENING; break;
      case FACE_SPEAKING: target = ISABELLA_SPEAKING; break;
      case FACE_HAPPY: target = ISABELLA_HAPPY; break;
      case FACE_LAUGH: target = ISABELLA_LAUGHING; break;
      case FACE_SURPRISED: target = ISABELLA_SURPRISED; break;
      case FACE_SAD: target = ISABELLA_SAD; break;
      case FACE_ERROR: target = ISABELLA_CONCERNED; break;
      case FACE_THINKING: target = ISABELLA_THINKING; break;
      case FACE_WORKING: target = ISABELLA_THINKING; break;
      case FACE_CURIOUS: target = ISABELLA_CURIOUS; break;
      case FACE_SLEEP: target = ISABELLA_SLEEPING; break;
      default: target = ISABELLA_NEUTRAL; break;
    }
    if (isabellaState != target) setIsabellaState(target);
    isabellaFrame = static_cast<uint8_t>(faceFrame);
  } else if (personality == PERSONALITY_SPARTAN) {
    if (importedCharacterStateOverride) {
      spartanFrame = static_cast<uint8_t>(faceFrame);
      return;
    }
    switch (faceMode) {
      case FACE_LISTENING: setSpartanState(SPARTAN_LISTENING); break;
      case FACE_THINKING: setSpartanState(SPARTAN_THINKING); break;
      case FACE_SPEAKING:
      case FACE_WORKING: setSpartanState(SPARTAN_COMMAND); break;
      case FACE_HAPPY: setSpartanState(SPARTAN_VICTORY); break;
      case FACE_LAUGH: setSpartanState(SPARTAN_LAUGHING); break;
      case FACE_SLEEP: setSpartanState(SPARTAN_SLEEPING); break;
      case FACE_CURIOUS: setSpartanState(SPARTAN_THINKING); break;
      default: setSpartanState(SPARTAN_GUARD); break;
    }
    spartanFrame = static_cast<uint8_t>(faceFrame);
  } else if (personality == PERSONALITY_ROCKY) {
    if (rockyCharacterStateOverride) return;
    switch (faceMode) {
      case FACE_LISTENING: RockyBodyLanguage::setIntegrationState("listening"); break;
      case FACE_THINKING: RockyBodyLanguage::setIntegrationState("curious"); break;
      case FACE_SPEAKING: RockyBodyLanguage::setIntegrationState("greeting"); break;
      case FACE_WORKING: RockyBodyLanguage::setIntegrationState("pace"); break;
      case FACE_HAPPY: RockyBodyLanguage::setIntegrationState("greeting"); break;
      case FACE_LAUGH: RockyBodyLanguage::setIntegrationState("dance"); break;
      case FACE_CURIOUS: RockyBodyLanguage::setIntegrationState("curious"); break;
      case FACE_SAD: RockyBodyLanguage::setIntegrationState("sleeping"); break;
      case FACE_SURPRISED: RockyBodyLanguage::setIntegrationState("wave"); break;
      case FACE_ERROR: RockyBodyLanguage::setIntegrationState("go back"); break;
      case FACE_SLEEP: RockyBodyLanguage::setIntegrationState("sleeping"); break;
      default: RockyBodyLanguage::setIntegrationState("idle"); break;
    }
  }
}

bool drawImportedCharacter() {
  syncImportedCharacterState();
  if (personality == PERSONALITY_ISABELLA) {
    drawIsabella();
    return true;
  }
  if (personality == PERSONALITY_SPARTAN) {
    drawSpartan();
    return true;
  }
  if (personality == PERSONALITY_ROCKY) {
    RockyBodyLanguage::renderIntegrationFrame();
    return true;
  }
  return false;
}

void setPan(int angle) {
  panAngle = constrain(angle, ROCKY_SERVO_MIN_ANGLE, ROCKY_SERVO_MAX_ANGLE);
  headServo.write(panAngle);
  lastEvent = "Pan " + String(panAngle) + " deg";
  Serial.println(lastEvent);
}

// ------------------------------ DRV8833 motor layer ------------------------------

void setMotorChannel(int in1, int in2, int signedPwm, bool invert) {
  if (invert) signedPwm = -signedPwm;
  int pwm = constrain(abs(signedPwm), 0, 255);
  if (signedPwm > 0) {
    analogWrite(in1, pwm);
    analogWrite(in2, 0);
  } else if (signedPwm < 0) {
    analogWrite(in1, 0);
    analogWrite(in2, pwm);
  } else {
    analogWrite(in1, 0);
    analogWrite(in2, 0);
  }
}

void driveMotors(const String &direction, int speed, uint32_t durationMs) {
  int pwm = constrain(speed, 0, 255);
  int left = 0;
  int right = 0;

  if (direction == "forward") {
    left = pwm; right = pwm;
  } else if (direction == "back") {
    left = -pwm; right = -pwm;
  } else if (direction == "left") {
    left = -pwm; right = pwm;
  } else if (direction == "right") {
    left = pwm; right = -pwm;
  } else {
    stopMotors("Unknown motor direction");
    return;
  }

  setMotorChannel(ROCKY_LEFT_IN1, ROCKY_LEFT_IN2, left, leftMotorInvert);
  setMotorChannel(ROCKY_RIGHT_IN1, ROCKY_RIGHT_IN2, right, rightMotorInvert);
  lastMotorCommand = millis();
  lastEvent = "Motor " + direction;
  setFace(FACE_HAPPY, lastEvent);
  Serial.println(lastEvent);
  (void)durationMs; // safety timeout is the hard stop boundary
}

void stopMotors(const String &reason) {
  setMotorChannel(ROCKY_LEFT_IN1, ROCKY_LEFT_IN2, 0, false);
  setMotorChannel(ROCKY_RIGHT_IN1, ROCKY_RIGHT_IN2, 0, false);
  lastMotorCommand = millis();
  lastEvent = reason;
}

// ------------------------------ Wi-Fi layer ------------------------------

bool tryWiFiProfiles() {
  if (!wifiProfileConfigured(wifiProfiles[0]) && !wifiProfileConfigured(wifiProfiles[1])) {
    return false;
  }

  provisioningAP = false;
  WiFi.mode(WIFI_STA);
  WiFi.setHostname("deskbot-xiao");

  for (int index = 0; index < 2; ++index) {
    if (!wifiProfileConfigured(wifiProfiles[index])) continue;
    activeWifiIndex = index;
    Serial.print("Connecting to Wi-Fi profile ");
    Serial.print(index + 1);
    Serial.print(": ");
    Serial.println(wifiProfiles[index].ssid);
    WiFi.disconnect();
    delay(100);
    WiFi.begin(wifiProfiles[index].ssid.c_str(), wifiProfiles[index].password.c_str());

    const unsigned long started = millis();
    while (WiFi.status() != WL_CONNECTED && millis() - started < 8000UL) {
      delay(250);
      Serial.print(".");
    }
    Serial.println();
    if (WiFi.status() == WL_CONNECTED) {
      wifiUnavailableSince = 0;
      Serial.print("WIFI OK profile "); Serial.print(index + 1); Serial.print(" IP: "); Serial.println(WiFi.localIP());
      Serial.print("DASHBOARD: http://"); Serial.println(WiFi.localIP());
      Serial.println("Open that URL from a phone/computer on the same 2.4 GHz Wi-Fi.");
      lastEvent = "Wi-Fi connected: profile " + String(index + 1);
      return true;
    }
  }

  if (wifiUnavailableSince == 0) wifiUnavailableSince = millis();
  activeWifiIndex = -1;
  Serial.println("No saved Wi-Fi profile is currently available; retrying both profiles.");
  Serial.println("Setup AP will become available automatically after 5 minutes without a network.");
  lastEvent = "Wi-Fi unavailable; retrying two profiles";
  return false;
}

void connectStoredWiFi() {
  if (!wifiProfileConfigured(wifiProfiles[0]) && !wifiProfileConfigured(wifiProfiles[1])) {
    Serial.println("No Wi-Fi profiles stored; starting initial setup AP");
    startAccessPoint();
    return;
  }
  wifiUnavailableSince = millis();
  if (!tryWiFiProfiles()) {
    Serial.println("The board will keep retrying both networks before opening the setup AP.");
  }
}

void startAccessPoint() {
  provisioningAP = true;
  apStartedAt = millis();
  WiFi.disconnect(true, true);
  delay(200);
  WiFi.mode(WIFI_AP);
  IPAddress apIp(192, 168, 4, 1);
  IPAddress apGateway(192, 168, 4, 1);
  IPAddress apMask(255, 255, 255, 0);
  WiFi.softAPConfig(apIp, apGateway, apMask);
  WiFi.softAP("Rocky-XIAO-Setup");
  Serial.print("SETUP AP: Rocky-XIAO-Setup IP: "); Serial.println(WiFi.softAPIP());
  Serial.println("DASHBOARD: http://192.168.4.1");
  Serial.println("Connect to Rocky-XIAO-Setup, open http://192.168.4.1, and save one or two 2.4 GHz Wi-Fi profiles.");
  lastEvent = "Wi-Fi setup AP active";
}

void maintainWiFi() {
  if (provisioningAP) return;
  if (WiFi.status() == WL_CONNECTED) {
    wifiUnavailableSince = 0;
    return;
  }

  if (wifiUnavailableSince == 0) wifiUnavailableSince = millis();
  if (millis() - wifiUnavailableSince >= WIFI_FALLBACK_AP_AFTER_MS) {
    Serial.println("Wi-Fi unavailable for 5 minutes; opening setup AP");
    startAccessPoint();
    return;
  }

  if (millis() - lastWiFiAttempt < ROCKY_WIFI_RETRY_MS) return;
  lastWiFiAttempt = millis();
  Serial.println("Wi-Fi reconnect attempt: trying both profiles");
  tryWiFiProfiles();
}

bool initMicrophone() {
  microphone.setPinsPdmRx(ROCKY_PDM_MIC_CLOCK, ROCKY_PDM_MIC_DATA);
  if (!microphone.begin(I2S_MODE_PDM_RX, 16000, I2S_DATA_BIT_WIDTH_16BIT, I2S_SLOT_MODE_MONO)) {
    Serial.println("MIC ERROR: PDM microphone initialization failed");
    return false;
  }
  Serial.println("MIC OK: XIAO Sense PDM microphone at 16 kHz");
  return true;
}

String microphoneStatusName() {
  if (!microphoneReady) return "not_ready";
  if (microphoneMonitor) return "monitoring";
  return "ready";
}

bool initAudio() {
  // ESP32 Arduino allocates an available I2S channel for this second I2SClass.
  // The PDM RX microphone and standard TX amplifier remain separate objects.
  audioOutput.setPins(ROCKY_AUDIO_BCLK, ROCKY_AUDIO_LRCK, ROCKY_AUDIO_DATA);
  if (!audioOutput.begin(I2S_MODE_STD, 16000, I2S_DATA_BIT_WIDTH_16BIT, I2S_SLOT_MODE_STEREO)) {
    Serial.println("AUDIO ERROR: MAX98357A I2S initialization failed");
    return false;
  }
  Serial.println("AUDIO OK: MAX98357A I2S output at 16 kHz");
  return true;
}

String audioStatusName() {
  if (!audioReady) return "not_ready";
  if (microphoneLoopback) return "mic_loopback";
  return audioToneActive ? "tone" : "ready";
}

void startAudioTone(int frequency, uint32_t durationMs) {
  if (!audioReady) {
    Serial.println("AUDIO ERROR: initialize MAX98357A output first");
    return;
  }
  audioToneFrequency = constrain(frequency, 100, 4000);
  audioTonePhase = 0;
  audioTonePhaseStep = (uint32_t)(((uint64_t)audioToneFrequency << 32) / 16000ULL);
  audioToneUntil = millis() + durationMs;
  audioToneActive = true;
  setFace(FACE_SPEAKING, "Audio tone");
  Serial.print("AUDIO: tone ");
  Serial.print(audioToneFrequency);
  Serial.print(" Hz for ");
  Serial.print(durationMs);
  Serial.println(" ms");
}

void stopAudio(const String &reason) {
  audioToneActive = false;
  audioToneUntil = 0;
  if (microphoneLoopback) {
    microphoneLoopback = false;
    microphoneMonitor = false;
    microphoneLoopbackUntil = 0;
  }
  lastEvent = reason;
  if (faceMode == FACE_SPEAKING) setFace(FACE_IDLE, reason);
  else Serial.println(reason);
}

void updateAudioTone() {
  if (!audioReady || !audioToneActive) return;
  if ((int32_t)(millis() - audioToneUntil) >= 0) {
    stopAudio("Audio tone complete");
    return;
  }

  int16_t stereoSamples[64 * 2];
  for (size_t i = 0; i < 64; ++i) {
    const int32_t raw = (audioTonePhase & 0x80000000UL) ? 1800 : -1800;
    const int16_t sample = static_cast<int16_t>((raw * speakerVolume) / 100);
    stereoSamples[i * 2] = sample;
    stereoSamples[i * 2 + 1] = sample;
    audioTonePhase += audioTonePhaseStep;
  }
  audioOutput.write(reinterpret_cast<const uint8_t *>(stereoSamples), sizeof(stereoSamples));
}

void updateMicrophone() {
  if (!microphoneReady || (!microphoneMonitor && !microphoneLoopback)) return;
  if (millis() >= microphoneMonitorUntil && microphoneMonitor) {
    microphoneMonitor = false;
    if (!microphoneLoopback) {
      microphoneLevel = 0;
      setFace(FACE_IDLE, "Microphone monitor complete");
      return;
    }
  }
  if (millis() >= microphoneLoopbackUntil && microphoneLoopback) {
    stopMicLoopback("Microphone loopback complete");
    return;
  }
  if (millis() - lastMicRead < 20 || microphone.available() <= 0) return;
  lastMicRead = millis();

  int16_t samples[256];
  size_t bytes = microphone.readBytes((char *)samples, sizeof(samples));
  size_t count = bytes / sizeof(int16_t);
  if (count == 0) return;

  uint32_t total = 0;
  for (size_t i = 0; i < count; i++) {
    int32_t sample = samples[i];
    if (sample < 0) sample = -sample;
    total += (uint32_t)sample;
  }
  uint32_t average = total / count;
  const uint32_t noiseFloor = 180;
  uint32_t aboveFloor = average > noiseFloor ? average - noiseFloor : 0;
  int rawLevel = constrain((int)(aboveFloor / 110), 0, 99);
  static int smoothedLevel = 0;
  smoothedLevel = (smoothedLevel * 7 + rawLevel * 3) / 10;
  microphoneLevel = smoothedLevel < 2 ? 0 : smoothedLevel;

  if (microphoneLoopback && audioReady && speakerVolume > 0) {
    int16_t stereoSamples[256 * 2];
    for (size_t i = 0; i < count; ++i) {
      int32_t scaled = ((int32_t)samples[i] * speakerVolume) / 100;
      scaled = constrain(scaled, -32768L, 32767L);
      stereoSamples[i * 2] = (int16_t)scaled;
      stereoSamples[i * 2 + 1] = (int16_t)scaled;
    }
    audioOutput.write(reinterpret_cast<const uint8_t *>(stereoSamples), count * 2 * sizeof(int16_t));
  }

  if (millis() - lastMicPrint >= 250) {
    lastMicPrint = millis();
    Serial.print("MIC level: "); Serial.print(microphoneLevel);
    if (microphoneLoopback) {
      Serial.print(" | loopback volume: "); Serial.print(speakerVolume); Serial.println("%");
    } else {
      Serial.println();
    }
  }
}

void startMicLoopback(uint32_t durationMs) {
  if (!microphoneReady || !audioReady) {
    Serial.println("MIC LOOPBACK ERROR: microphone and audio must both be ready");
    return;
  }
  audioToneActive = false;
  microphoneMonitor = true;
  microphoneLoopback = true;
  microphoneMonitorUntil = millis() + durationMs;
  microphoneLoopbackUntil = millis() + durationMs;
  wakeNameEngaged = false;
  setFace(FACE_LISTENING, "Microphone to speaker loopback");
  Serial.print("MIC LOOPBACK: active for "); Serial.print(durationMs / 1000UL);
  Serial.print(" seconds at volume "); Serial.print(speakerVolume); Serial.println("%");
}

void stopMicLoopback(const String &reason) {
  microphoneLoopback = false;
  microphoneMonitor = false;
  microphoneLoopbackUntil = 0;
  microphoneMonitorUntil = 0;
  microphoneLevel = 0;
  if (faceMode == FACE_LISTENING) setFace(FACE_IDLE, reason);
  else Serial.println(reason);
}

void setSpeakerVolume(int percent) {
  speakerVolume = constrain(percent, 0, 100);
  preferences.putUChar("spkVol", (uint8_t)speakerVolume);
  lastEvent = "Speaker volume " + String(speakerVolume) + "%";
  Serial.println(lastEvent);
}

void engageWakeName(const String &source) {
  if (!wakeNameEnabled) {
    Serial.println("Wake name is disabled");
    return;
  }
  wakeNameEngaged = true;
  wakeEngagedUntil = millis() + 10000UL;
  setFace(FACE_LISTENING, "Wake name engaged: " + wakeName);
  startAudioTone(880, 100);
  Serial.print("WAKE: "); Serial.print(wakeName); Serial.print(" recognized via "); Serial.println(source);
}

void applyStateHeadPose() {
  if (!headFollowsState || danceActive) return;
  int target = 90;
  switch (faceMode) {
    case FACE_LISTENING: target = 90; break;
    case FACE_THINKING: target = 118; break;
    case FACE_WORKING: target = 62; break;
    case FACE_CURIOUS: target = 125; break;
    case FACE_SAD: target = 72; break;
    case FACE_ERROR: target = 58; break;
    default: target = 90; break;
  }
  panAngle = constrain(target, ROCKY_SERVO_MIN_ANGLE, ROCKY_SERVO_MAX_ANGLE);
  headServo.write(panAngle);
}

void startDance() {
  danceActive = true;
  danceStep = 0;
  danceStepStarted = 0;
  lastEvent = "Dance started";
  Serial.println(lastEvent);
}

void stopDance(const String &reason) {
  danceActive = false;
  stopMotors(reason);
  panAngle = 90;
  headServo.write(panAngle);
  setFace(FACE_IDLE, reason);
}

void updateDance() {
  if (!danceActive) return;
  const unsigned long stepMs = 650;
  if (danceStepStarted != 0 && millis() - danceStepStarted < stepMs) return;
  danceStepStarted = millis();

  switch (danceStep) {
    case 0: setPan(90); setFace(FACE_HAPPY, "Dance center"); stopMotors("Dance pause"); break;
    case 1: setPan(58); setFace(FACE_CURIOUS, "Dance look left"); driveMotors("left", motorSpeed, stepMs); break;
    case 2: setPan(122); setFace(FACE_HAPPY, "Dance look right"); driveMotors("right", motorSpeed, stepMs); break;
    case 3: setPan(90); setFace(FACE_SURPRISED, "Dance bounce"); driveMotors("forward", motorSpeed, stepMs); break;
    case 4: setPan(70); setFace(FACE_LAUGH, "Dance sway left"); driveMotors("left", motorSpeed, stepMs); break;
    case 5: setPan(110); setFace(FACE_LAUGH, "Dance sway right"); driveMotors("right", motorSpeed, stepMs); break;
    case 6: setPan(90); setFace(FACE_HAPPY, "Dance finish"); driveMotors("back", motorSpeed, stepMs); break;
    default: stopDance("Dance complete"); return;
  }
  danceStep++;
}

bool initCamera() {
#if ROCKY_CAMERA_ENABLED
  camera_config_t config;
  config.ledc_channel = LEDC_CHANNEL_0;
  config.ledc_timer = LEDC_TIMER_0;
  config.pin_d0 = ROCKY_CAMERA_Y2;
  config.pin_d1 = ROCKY_CAMERA_Y3;
  config.pin_d2 = ROCKY_CAMERA_Y4;
  config.pin_d3 = ROCKY_CAMERA_Y5;
  config.pin_d4 = ROCKY_CAMERA_Y6;
  config.pin_d5 = ROCKY_CAMERA_Y7;
  config.pin_d6 = ROCKY_CAMERA_Y8;
  config.pin_d7 = ROCKY_CAMERA_Y9;
  config.pin_xclk = ROCKY_CAMERA_XCLK;
  config.pin_pclk = ROCKY_CAMERA_PCLK;
  config.pin_vsync = ROCKY_CAMERA_VSYNC;
  config.pin_href = ROCKY_CAMERA_HREF;
  config.pin_sccb_sda = ROCKY_CAMERA_SIOD;
  config.pin_sccb_scl = ROCKY_CAMERA_SIOC;
  config.pin_pwdn = ROCKY_CAMERA_PWDN;
  config.pin_reset = ROCKY_CAMERA_RESET;
  config.xclk_freq_hz = 20000000;
  config.pixel_format = PIXFORMAT_JPEG;
  config.frame_size = ROCKY_CAMERA_FRAME_SIZE;
  config.jpeg_quality = ROCKY_CAMERA_JPEG_QUALITY;
  config.fb_count = psramFound() ? 2 : 1;
  config.grab_mode = psramFound() ? CAMERA_GRAB_LATEST : CAMERA_GRAB_WHEN_EMPTY;
  config.fb_location = psramFound() ? CAMERA_FB_IN_PSRAM : CAMERA_FB_IN_DRAM;

  esp_err_t err = esp_camera_init(&config);
  if (err != ESP_OK) {
    Serial.printf("CAMERA ERROR: init failed 0x%x\n", err);
    return false;
  }

  sensor_t *sensor = esp_camera_sensor_get();
  if (sensor && sensor->id.PID == OV3660_PID) {
    sensor->set_vflip(sensor, 1);
    sensor->set_brightness(sensor, 1);
    sensor->set_saturation(sensor, -2);
  }
  Serial.println("CAMERA OK: XIAO Sense JPEG snapshot ready");
  return true;
#else
    Serial.println("CAMERA DISABLED in boards/xiao-esp32s3-sense/pinmap.h");
  return false;
#endif
}

void handleCameraJpg() {
  if (!cameraReady) {
    server.send(503, "text/plain", "Camera is not initialized");
    return;
  }
  if (cameraBusy) {
    server.send(429, "text/plain", "Camera busy; retry");
    return;
  }

  cameraBusy = true;
  camera_fb_t *fb = esp_camera_fb_get();
  if (!fb) {
    cameraBusy = false;
    server.send(503, "text/plain", "Camera capture failed");
    return;
  }

  // Some ESP32 WebServer versions return NetworkClient&, while older or
  // alternate WebServer libraries return a WiFiClient temporary. Store a
  // client value instead of binding a non-const reference to the result.
  WiFiClient client = server.client();
  client.print("HTTP/1.1 200 OK\r\n");
  client.print("Content-Type: image/jpeg\r\n");
  client.print("Content-Length: ");
  client.print(fb->len);
  client.print("\r\nCache-Control: no-store\r\nConnection: close\r\n\r\n");
  client.write(fb->buf, fb->len);
  esp_camera_fb_return(fb);
  cameraBusy = false;
}

void handleCameraLive() {
  String html = pageHeader("Live XIAO Camera");
  html += "<h1>Live camera</h1><p class='muted'>Low-rate live mode: the browser requests a fresh JPEG snapshot several times per second. This keeps the XIAO responsive for the OLED, servo, motors, and microphone.</p>";
  html += "<img id='live' style='width:100%;max-width:640px;border-radius:10px;background:#080a0e' alt='Live camera preview'>";
  html += "<p><button onclick='startLive()'>Start</button><button onclick='stopLive()'>Stop</button><a class='button' href='/'>Back to dashboard</a></p>";
  html += "<pre id='fps'>stopped</pre>";
  html += "<script>let timer=null,count=0,last=Date.now();function tick(){let img=document.getElementById('live');img.src='/camera.jpg?live='+Date.now();count++;let now=Date.now();if(now-last>1000){document.getElementById('fps').textContent='refreshes/sec: '+count;count=0;last=now}}function startLive(){stopLive();tick();timer=setInterval(tick,300)}function stopLive(){if(timer){clearInterval(timer);timer=null}document.getElementById('fps').textContent='stopped'}startLive();</script></body></html>";
  server.send(200, "text/html", html);
}

// ------------------------------ HTTP/dashboard layer ------------------------------

void setupRoutes() {
  server.on("/", HTTP_GET, handleRoot);
  server.on("/health", HTTP_GET, handleHealth);
  server.on("/api/status", HTTP_GET, handleStatus);
  server.on("/api/changes", HTTP_GET, handleChanges);
  server.on("/api/ota/catalog", HTTP_GET, handleOtaCatalog);
  server.on("/oled.svg", HTTP_GET, handleOledSvg);
  server.on("/camera.jpg", HTTP_GET, handleCameraJpg);
  server.on("/camera/live", HTTP_GET, handleCameraLive);
  server.on("/cmd", HTTP_GET, handleCommand);
  server.on("/wifi", HTTP_GET, handleWiFiForm);
  server.on("/wifi", HTTP_POST, handleWiFiSave);
  server.onNotFound(handleNotFound);
}

void handleRoot() {
  String html = pageHeader("Rocky XIAO Desk Buddy");
  html += R"DESKBOT(<header><div><h1>Rocky XIAO Desk Buddy</h1><p class='muted'>Local control centre • dual Wi-Fi • remote OLED • versioned OTA</p></div><div id='netBadge' class='badge'>Loading network...</div></header>)DESKBOT";
  html += R"DESKBOT(<nav class='quickNav' aria-label='Dashboard sections'><a href='#statusCard'>Status</a><a href='#facesCard'>Faces</a><a href='#motionCard'>Motion</a><a href='#audioCard'>Audio</a><a href='#cameraCard'>Camera</a><a href='#otaCard'>OTA</a></nav>)DESKBOT";
  html += R"DESKBOT(<section id='statusCard' class='hero'><div><h2>Live board monitor</h2><p class='muted'>This page stays on your local network. The OLED mirror refreshes without requiring the physical display to be nearby.</p><pre id='status'>Loading...</pre><div class='buttonRow'><button onclick='refreshStatus()'>Refresh status</button><a class='button' href='/health' target='_blank'>Health check</a></div></div><div class='oledCard'><div class='muted'>OLED mirror</div><img id='oledMirror' src='/oled.svg' alt='Remote OLED display'><div id='oledTime' class='muted'>updating...</div></div></section>)DESKBOT";
  html += R"DESKBOT(<section class='releaseCard'><div class='releaseTop'><div><h2>What changed</h2><p id='releaseSummary' class='muted'>Loading release notes...</p></div><span id='releaseVersion' class='releaseVersion'>Release</span></div><ul id='releaseChanges' class='changes'><li>Loading changes...</li></ul><a class='button' href='/api/changes' target='_blank'>Open changes JSON</a></section>)DESKBOT";
  html += R"DESKBOT(<section id='facesCard'><h2>Face states</h2><div class='controlGrid'>)DESKBOT";
  const char *faces[] = {"idle", "listening", "thinking", "speaking", "working", "happy", "laugh", "curious", "sad", "surprised", "error", "sleep"};
  for (const char *face : faces) html += "<button onclick=\"cmd('face " + String(face) + "')\">" + String(face) + "</button>";
  html += R"DESKBOT(</div></section><section><h2>Personalities</h2><div class='controlGrid'><button onclick="cmd('personality calm')">Calm</button><button onclick="cmd('personality rocky')">Rocky</button><button onclick="cmd('personality engineer')">Engineer</button><button onclick="cmd('personality spartan')">Spartan</button><button class='isabella' onclick="cmd('personality isabella')">Isabella</button></div></section>)DESKBOT";
  html += R"DESKBOT(<section><h2>OLED display</h2><p class='muted'>Invert the physical OLED palette without reflashing.</p><div class='controlGrid'><button onclick="cmd('oled invert on')">Invert ON</button><button onclick="cmd('oled invert off')">Invert OFF</button><button onclick="cmd('oled invert toggle')">Toggle</button></div></section>)DESKBOT";
  html += R"DESKBOT(<section><h2>Pan servo</h2><div class='controlGrid'><button onclick="cmd('pan 0')">0°</button><button onclick="cmd('pan 90')">90°</button><button onclick="cmd('pan 180')">180°</button></div><div class='inlineControl'><label for='angle'>Custom angle</label><input id='angle' type='number' min='0' max='180' value='90'><button onclick="cmd('pan '+document.getElementById('angle').value)">Move</button></div></section>)DESKBOT";
  html += R"DESKBOT(<section id='motionCard'><h2>Head, dance, and motors</h2><div class='controlGrid'><button onclick="cmd('head auto')">Head follows state</button><button onclick="cmd('head off')">Head fixed</button><button onclick="cmd('dance start')">Dance</button><button class='stop' onclick="cmd('dance stop')">Stop dance</button></div><p class='warn'>Keep the robot lifted and motor power controlled during tests.</p><div class='controlGrid'><button onclick="cmd('motor forward')">Forward</button><button onclick="cmd('motor back')">Back</button><button onclick="cmd('motor left')">Left</button><button onclick="cmd('motor right')">Right</button><button class='stop' onclick="cmd('motor stop')">STOP</button></div><div class='inlineControl'><label for='speed'>Motor speed</label><input id='speed' type='number' min='0' max='255' value='100'><button onclick="cmd('motor speed '+document.getElementById('speed').value)">Set speed</button></div></section>)DESKBOT";
  html += R"DESKBOT(<section id='audioCard'><h2>Microphone and speaker</h2><div class='controlGrid'><button onclick="cmd('test mic')">Mic to speaker</button><button onclick="cmd('mic monitor')">Mic meter only</button><button onclick="cmd('mic off')">Stop mic</button><button onclick="cmd('test audio')">Test tone</button></div><div class='inlineControl'><label for='volume'>Speaker volume %</label><input id='volume' type='number' min='0' max='100' value='20'><button onclick="cmd('audio volume '+document.getElementById('volume').value)">Set volume</button></div></section>)DESKBOT";
  html += R"DESKBOT(<section id='cameraCard'><h2>Camera</h2><img id='camera' class='camera' alt='Camera preview'><div class='controlGrid'><button onclick='refreshCamera()'>Snapshot</button><a class='button' href='/camera/live' target='_blank'>Live mode</a><a class='button' href='/camera.jpg' target='_blank'>Open JPEG</a></div></section>)DESKBOT";
  html += R"DESKBOT(<section><h2>Wi-Fi networks</h2><p class='muted'>Two saved 2.4 GHz profiles are tried in order. If neither is available for five minutes, the board starts Rocky-XIAO-Setup at 192.168.4.1.</p><a class='button' href='/wifi'>Configure two networks</a></section>)DESKBOT";
  html += R"DESKBOT(<section id='otaCard'><h2>Firmware and OTA</h2><div id='otaBanner' class='ota idle'>OTA status: loading</div><pre id='ota'>Loading...</pre><label for='otaTarget'>Target version</label><select id='otaTarget'><option value=''>Latest release</option></select><div class='controlGrid'><button onclick="setOtaTarget()">Set target</button><button onclick="cmd('ota latest')">Use latest</button><button class='warnButton' onclick="cmd('restart')">Restart and check OTA</button></div><p class='muted'>The OTA check now starts a few seconds after boot so the dashboard becomes available first. Selecting a specific version is an explicit upgrade/downgrade request.</p><h3>Version history</h3><div id='versionHistory' class='versionList'>Loading published versions...</div></section>)DESKBOT";
  html += R"DESKBOT(<script>
async function cmd(c){try{let r=await fetch('/cmd?c='+encodeURIComponent(c));let t=await r.text();document.getElementById('status').textContent=t;await refreshStatus()}catch(e){document.getElementById('status').textContent='Command failed: '+e}}
function setOtaTarget(){let v=document.getElementById('otaTarget').value;cmd(v?'ota target '+v:'ota latest')}
function otaText(s){let text='firmware: '+s.firmware+'\nnetwork: '+s.network+'\nactive Wi-Fi profile: '+s.activeWifiProfile+'\nOLED mirror: /oled.svg\nOTA state: '+s.otaState+'\nremote version: '+(s.otaRemoteVersion||'unknown')+'\ntarget version: '+(s.otaTargetVersion||'latest')+'\nprogress: '+s.otaProgress+'%';if(s.otaError)text+='\nerror: '+s.otaError;return text}
function otaBanner(s){let el=document.getElementById('otaBanner');el.className='ota '+s.otaState;let label=s.otaState.replaceAll('_',' ');el.textContent='OTA status: '+label+(s.otaRemoteVersion?' | remote '+s.otaRemoteVersion:'')+(s.otaTargetVersion?' | target '+s.otaTargetVersion:'')}
async function refreshStatus(){try{let r=await fetch('/api/status?ts='+Date.now());if(!r.ok)throw new Error('HTTP '+r.status);let s=await r.json();document.getElementById('status').textContent=JSON.stringify(s,null,2);document.getElementById('ota').textContent=otaText(s);otaBanner(s);document.getElementById('netBadge').textContent=s.network==='wifi_connected'?'Wi-Fi profile '+s.activeWifiProfile:s.network==='setup_ap'?'Setup AP 192.168.4.1':'Network unavailable'}catch(e){document.getElementById('status').textContent='Dashboard cannot reach device: '+e}}
async function refreshCatalog(){try{let r=await fetch('/api/ota/catalog?ts='+Date.now());if(!r.ok)return;let c=await r.json();let select=document.getElementById('otaTarget');let current=select.value;select.innerHTML='<option value="">Latest release</option>';let history=document.getElementById('versionHistory');history.innerHTML='';(c.versions||[]).forEach(v=>{let o=document.createElement('option');o.value=v.version;o.textContent=v.version+(v.current?' (current release)':'');select.appendChild(o);let row=document.createElement('div');row.className='versionRow';let label=document.createElement('span');label.textContent='v'+v.version+(v.current?' • current':'');row.appendChild(label);if(v.firmware){let link=document.createElement('a');link.className='button smallButton';link.href=v.firmware;link.target='_blank';link.textContent='Firmware';row.appendChild(link)}history.appendChild(row)});if(!history.children.length)history.textContent='No published catalog entries are available yet.';select.value=current}catch(e){}}
function refreshOled(){let img=document.getElementById('oledMirror');if(img)img.src='/oled.svg?ts='+Date.now();document.getElementById('oledTime').textContent='last refresh: '+new Date().toLocaleTimeString()}
function refreshCamera(){if(document.getElementById('camera'))document.getElementById('camera').src='/camera.jpg?ts='+Date.now()}
async function refreshChanges(){try{let r=await fetch('/api/changes?ts='+Date.now());if(!r.ok)return;let c=await r.json();document.getElementById('releaseVersion').textContent='v'+c.version;document.getElementById('releaseSummary').textContent=c.summary;document.getElementById('releaseChanges').innerHTML=(c.changes||[]).map(x=>'<li>'+x+'</li>').join('')}catch(e){document.getElementById('releaseSummary').textContent='Release notes unavailable'}}
refreshStatus();refreshCatalog();refreshChanges();refreshOled();refreshCamera();setInterval(refreshStatus,5000);setInterval(refreshChanges,30000);setInterval(refreshOled,1000);
</script></body></html>)DESKBOT";
  server.send(200, "text/html", html);
}

void handleHealth() {
  server.send(200, "text/plain", "deskbot-ok");
}

void handleStatus() {
  String json = "{";
  json += "\"network\":\"" + htmlEscape(networkModeName()) + "\",";
  json += "\"ip\":\"" + (provisioningAP ? WiFi.softAPIP().toString() : WiFi.localIP().toString()) + "\",";
  json += "\"ssid\":\"" + htmlEscape(WiFi.status() == WL_CONNECTED ? WiFi.SSID() : savedSsid) + "\",";
  json += "\"wifiProfile1\":\"" + htmlEscape(savedSsid) + "\",";
  json += "\"wifiProfile2\":\"" + htmlEscape(savedSsid2) + "\",";
  json += "\"activeWifiProfile\":" + String(activeWifiIndex >= 0 ? activeWifiIndex + 1 : 0) + ",";
  json += "\"wifiFallbackSeconds\":" + String((wifiUnavailableSince > 0 && !provisioningAP && millis() > wifiUnavailableSince) ? (millis() - wifiUnavailableSince) / 1000UL : 0) + ",";
  json += "\"setupAp\":" + String(provisioningAP ? "true" : "false") + ",";
  json += "\"rssi\":" + String(provisioningAP ? 0 : WiFi.RSSI()) + ",";
  json += "\"face\":\"" + faceName() + "\",";
  json += "\"personality\":\"" + personalityName() + "\",";
  json += "\"pan\":" + String(panAngle) + ",";
  json += "\"motorDriver\":\"" + motorDriverName() + "\",";
  json += "\"motorSpeed\":" + String(motorSpeed) + ",";
  json += "\"camera\":\"" + cameraStatusName() + "\",";
  json += "\"microphone\":\"" + microphoneStatusName() + "\",";
  json += "\"micLevel\":" + String(microphoneLevel) + ",";
  json += "\"micLoopback\":" + String(microphoneLoopback ? "true" : "false") + ",";
  json += "\"speakerVolume\":" + String(speakerVolume) + ",";
  json += "\"wakeName\":\"" + htmlEscape(wakeName) + "\",";
  json += "\"wakeEnabled\":" + String(wakeNameEnabled ? "true" : "false") + ",";
  json += "\"wakeEngaged\":" + String(wakeNameEngaged ? "true" : "false") + ",";
  json += "\"audio\":\"" + audioStatusName() + "\",";
  json += "\"headFollowsState\":" + String(headFollowsState ? "true" : "false") + ",";
  json += "\"dance\":" + String(danceActive ? "true" : "false") + ",";
  json += "\"motorInvertLeft\":" + String(leftMotorInvert ? "true" : "false") + ",";
  json += "\"motorInvertRight\":" + String(rightMotorInvert ? "true" : "false") + ",";
  json += "\"oledInverted\":" + String(oledInverted ? "true" : "false") + ",";
  json += "\"boardId\":\"" + otaService.boardId() + "\",";
  json += "\"firmware\":\"" + String(APP_VERSION) + "\",";
  json += "\"otaConfigured\":" + String(OTA_MANIFEST_URL[0] != '\0' ? "true" : "false") + ",";
  json += "\"otaState\":\"" + String(otaService.stateName()) + "\",";
  json += "\"otaRemoteVersion\":\"" + htmlEscape(String(otaService.remoteVersion())) + "\",";
  json += "\"otaTargetVersion\":\"" + htmlEscape(String(otaService.targetVersion())) + "\",";
  json += "\"otaCatalogUrl\":\"" + htmlEscape(String(otaService.catalogUrl())) + "\",";
  json += "\"otaProgress\":" + String(otaService.progress()) + ",";
  json += "\"otaUpdateAvailable\":" + String(otaService.updateAvailable() ? "true" : "false") + ",";
  json += "\"otaError\":\"" + htmlEscape(String(otaService.lastError())) + "\",";
  json += "\"time\":\"" + currentTimeText() + "\",";
  json += "\"lastEvent\":\"" + htmlEscape(lastEvent) + "\"";
  json += "}";
  server.send(200, "application/json", json);
}

void handleChanges() {
  String json = "{\"version\":\"" + String(DESKBOT_RELEASE_VERSION) +
                "\",\"title\":\"" + String(DESKBOT_RELEASE_TITLE) +
                "\",\"summary\":\"" + String(DESKBOT_RELEASE_SUMMARY) +
                "\",\"changes\":[";
  for (uint8_t i = 0; i < DESKBOT_RELEASE_CHANGE_COUNT; ++i) {
    if (i > 0) json += ",";
    json += "\"" + htmlEscape(String(DESKBOT_RELEASE_CHANGES[i])) + "\"";
  }
  json += "]}";
  server.send(200, "application/json", json);
}

void handleCommand() {
  if (!server.hasArg("c")) {
    server.send(400, "text/plain", "Missing c parameter");
    return;
  }
  String command = server.arg("c");
  command.trim();
  lastCommand = command;
  String lower = command;
  lower.toLowerCase();

  // Keep one command implementation for Serial and HTTP.
  processSerialCommand(lower);
  server.send(200, "text/plain", "OK " + lastEvent);
}

void handleWiFiForm() {
  String html = pageHeader("Deskbot Wi-Fi setup");
  html += String("<header><div><h1>Deskbot Wi-Fi setup</h1><p class='muted'>Save two independent 2.4 GHz networks. The board tries profile 1, then profile 2.</p></div><div class='badge'>") + (provisioningAP ? "Setup AP" : "Connected dashboard") + "</div></header>";
  html += "<section class='hero'><div><h2>Network profiles</h2><form method='POST' action='/wifi'><label>Profile 1 SSID</label><input name='ssid1' required value='" + htmlEscape(savedSsid) + "'><label>Profile 1 password</label><input name='password1' type='password' placeholder='Leave blank for an open network'><label>Profile 2 SSID (optional)</label><input name='ssid2' value='" + htmlEscape(savedSsid2) + "'><label>Profile 2 password</label><input name='password2' type='password' placeholder='Leave blank for an open network'><button type='submit'>Save both profiles and reboot</button></form><p class='muted'>If both networks disappear while the board is running, the board retries them for five minutes, then opens Rocky-XIAO-Setup at 192.168.4.1.</p></div><div class='oledCard'><div class='muted'>OLED mirror</div><img id='oledMirror' src='/oled.svg' alt='Remote OLED display'><p class='muted'>The same mirror is available at <code>/oled.svg</code>.</p></div></section>";
  html += "<p><a class='button' href='/'>Back to dashboard</a></p><script>setInterval(function(){document.getElementById('oledMirror').src='/oled.svg?ts='+Date.now()},1000)</script></body></html>";
  server.send(200, "text/html", html);
}

void handleWiFiSave() {
  String ssid1 = server.hasArg("ssid1") ? server.arg("ssid1") : server.arg("ssid");
  String pass1 = server.hasArg("password1") ? server.arg("password1") : server.arg("password");
  String ssid2 = server.arg("ssid2");
  String pass2 = server.arg("password2");
  ssid1.trim(); ssid2.trim();
  if (ssid1.length() == 0) {
    server.send(400, "text/plain", "Profile 1 SSID cannot be empty");
    return;
  }
  if (pass1.length() == 0 && ssid1 == savedSsid) pass1 = savedPassword;
  if (pass2.length() == 0 && ssid2.length() > 0 && ssid2 == savedSsid2) pass2 = savedPassword2;
  preferences.putString("ssid", ssid1);
  preferences.putString("pass", pass1);
  preferences.putString("ssid2", ssid2);
  preferences.putString("pass2", pass2);
  server.send(200, "text/html", "<h1>Saved</h1><p>Both Wi-Fi profiles were saved. Rebooting; reconnect to your normal network and open the new dashboard IP.</p>");
  delay(700);
  ESP.restart();
}

void handleOledSvg() {
  if (!display.width()) {
    server.send(503, "text/plain", "OLED is not initialized");
    return;
  }
  uint8_t *buffer = display.getBuffer();
  if (!buffer) {
    server.send(503, "text/plain", "OLED framebuffer unavailable");
    return;
  }

  String svg;
  svg.reserve(24000);
  svg += "<svg xmlns='http://www.w3.org/2000/svg' viewBox='0 0 128 64' shape-rendering='crispEdges'><rect width='128' height='64' fill='#05070b'/>";
  for (int y = 0; y < 64; ++y) {
    int x = 0;
    while (x < 128) {
      const int index = (y / 8) * 128 + x;
      bool lit = (buffer[index] & (1 << (y & 7))) != 0;
      if (oledInverted) lit = !lit;
      if (!lit) { ++x; continue; }
      const int startX = x;
      while (x < 128) {
        const int nextIndex = (y / 8) * 128 + x;
        bool nextLit = (buffer[nextIndex] & (1 << (y & 7))) != 0;
        if (oledInverted) nextLit = !nextLit;
        if (!nextLit) break;
        ++x;
      }
      svg += "<rect x='" + String(startX) + "' y='" + String(y) + "' width='" + String(x - startX) + "' height='1' fill='white'/>";
    }
  }
  svg += "</svg>";
  server.sendHeader("Cache-Control", "no-store");
  server.send(200, "image/svg+xml", svg);
}

void handleOtaCatalog() {
  String catalog;
  if (!otaService.fetchCatalog(catalog)) {
    server.send(503, "application/json", "{\"versions\":[],\"error\":\"catalog unavailable\"}");
    return;
  }
  server.sendHeader("Cache-Control", "no-store");
  server.send(200, "application/json", catalog);
}

void handleNotFound() {
  server.send(404, "text/plain", "Not found");
}

String pageHeader(const String &title) {
  String html = "<!doctype html><html><head><meta charset='utf-8'><meta name='viewport' content='width=device-width,initial-scale=1,viewport-fit=cover'><meta name='theme-color' content='#0d111a'><title>" + htmlEscape(title) + R"DESKBOT(</title><style>
:root{color-scheme:dark}*{box-sizing:border-box}html{scroll-behavior:smooth}body{font-family:system-ui,-apple-system,BlinkMacSystemFont,'Segoe UI',sans-serif;background:#0d111a;color:#f3f5f7;max-width:1120px;width:100%;margin:0 auto;padding:12px;line-height:1.45;overflow-x:hidden}header{display:flex;justify-content:space-between;align-items:flex-start;gap:14px;margin:4px 0 10px;position:sticky;top:0;z-index:10;padding:8px 0;background:linear-gradient(#0d111a 76%,transparent);backdrop-filter:blur(8px)}header>div:first-child{min-width:0}h1{font-size:clamp(27px,5vw,44px);line-height:1.05;margin:4px 0}h2{font-size:clamp(20px,3vw,28px);margin:2px 0 8px}h3{margin-bottom:8px}section{background:#182131;border:1px solid #2b3850;border-radius:16px;padding:16px;margin:14px 0;box-shadow:0 8px 22px #0003;scroll-margin-top:74px}.hero{display:grid;grid-template-columns:minmax(0,1fr) 300px;gap:18px}.oledCard{background:#0a0e16;border-radius:12px;padding:12px;text-align:center}.oledCard img{display:block;width:100%;image-rendering:pixelated;border:1px solid #5f6f8d;border-radius:8px;background:#05070b;margin:8px 0}.badge{background:#28456e;color:#dcecff;border-radius:999px;padding:8px 12px;white-space:nowrap;font-size:13px}.quickNav{display:flex;gap:8px;overflow-x:auto;padding:2px 0 8px;scrollbar-width:thin}.quickNav a{flex:0 0 auto;background:#202d43;color:#dcecff;border:1px solid #385378;border-radius:999px;padding:8px 12px;text-decoration:none;font-size:13px}.releaseCard{border-color:#4a78b8;background:linear-gradient(135deg,#1b2c46,#182131)}.releaseTop{display:flex;justify-content:space-between;align-items:flex-start;gap:14px}.releaseVersion{background:#4b8df8;color:white;border-radius:999px;padding:8px 12px;font-weight:700;white-space:nowrap}.changes{padding-left:22px;margin-bottom:10px}.changes li{margin:7px 0;color:#dbe7f7}.controlGrid{display:grid;grid-template-columns:repeat(auto-fit,minmax(132px,1fr));gap:8px}.buttonRow{display:flex;flex-wrap:wrap;gap:8px}.buttonRow button,.buttonRow .button{margin:0}.inlineControl{display:grid;grid-template-columns:minmax(0,1fr) minmax(100px,180px) auto;gap:8px;align-items:end;margin-top:10px}.inlineControl label{margin:0}.camera{display:block;width:100%;max-width:700px;min-height:120px;object-fit:contain;border-radius:10px;background:#080a0e;margin:8px 0}.controlGrid button,.controlGrid .button{width:100%;margin:0;min-height:44px}.smallButton{min-height:0!important;padding:7px 10px!important;font-size:12px!important}.versionList{display:grid;gap:7px}.versionRow{display:flex;align-items:center;justify-content:space-between;gap:10px;background:#0c111a;border:1px solid #2d3c56;border-radius:9px;padding:8px 10px}.versionRow span{font-weight:600}.versionRow .button{width:auto}.warnButton{background:#9d6b16!important}.stop{background:#d63855}.isabella{background:#3478f6;border:1px solid #8db7ff}.warn{color:#ffd166}.muted{color:#aeb8c9}input,select{padding:11px;border-radius:8px;border:1px solid #76809a;background:#0f131c;color:white;margin:4px 0;width:100%;min-height:44px}label{display:block;margin-top:10px}pre{white-space:pre-wrap;overflow:auto;background:#0c0f15;padding:12px;border-radius:8px;font-size:13px;line-height:1.35}.ota{padding:12px;border-radius:8px;text-transform:capitalize;font-weight:600}.ota.up_to_date{background:#164b35;color:#b9ffd7}.ota.update_available,.ota.downloading,.ota.installing,.ota.rebooting{background:#594313;color:#ffe9a6}.ota.error{background:#5b1c2c;color:#ffd0da}.ota.disabled{background:#303744;color:#cbd5e1}@media(max-width:720px){body{padding:8px}header{display:block;padding-top:7px}header .badge{display:inline-block;margin-top:8px}.hero{grid-template-columns:1fr;gap:12px}section{padding:13px;margin:10px 0;border-radius:13px}.releaseTop{display:block}.releaseVersion{display:inline-block;margin-top:8px}.inlineControl{grid-template-columns:1fr 1fr}.inlineControl label{grid-column:1/-1}.inlineControl button{grid-column:1/-1;width:100%;min-height:44px}.oledCard{max-width:360px;margin:0 auto;width:100%}pre{font-size:11px}.quickNav{margin-inline:-2px}.versionRow{font-size:14px}}
</style></head><body>)DESKBOT";
  return html;
}

String htmlEscape(const String &value) {
  String out = value;
  out.replace("&", "&amp;");
  out.replace("<", "&lt;");
  out.replace(">", "&gt;");
  out.replace("\"", "&quot;");
  out.replace("'", "&#39;");
  return out;
}

// ------------------------------ Face/personality layer ------------------------------

String faceName() {
  switch (faceMode) {
    case FACE_IDLE: return "idle";
    case FACE_LISTENING: return "listening";
    case FACE_THINKING: return "thinking";
    case FACE_SPEAKING: return "speaking";
    case FACE_HAPPY: return "happy";
    case FACE_LAUGH: return "laugh";
    case FACE_CURIOUS: return "curious";
    case FACE_SAD: return "sad";
    case FACE_SURPRISED: return "surprised";
    case FACE_WORKING: return "working";
    case FACE_ERROR: return "error";
    case FACE_SLEEP: return "sleep";
  }
  return "unknown";
}

String personalityName() {
  switch (personality) {
    case PERSONALITY_CALM: return "calm";
    case PERSONALITY_ROCKY: return "rocky";
    case PERSONALITY_ENGINEER: return "engineer";
    case PERSONALITY_SPARTAN: return "spartan";
    case PERSONALITY_ISABELLA: return "isabella";
  }
  return "calm";
}

String networkModeName() {
  if (provisioningAP) return "setup_ap";
  if (WiFi.status() == WL_CONNECTED) return "wifi_connected";
  return "wifi_disconnected";
}

String motorDriverName() {
  return "DRV8833 direct PWM inputs";
}

String cameraStatusName() {
  if (cameraReady) return "ready_snapshot";
  return "not_ready";
}

String currentTimeText() {
  struct tm timeinfo;
  if (!getLocalTime(&timeinfo, 20)) return "not synced";
  char buffer[20];
  strftime(buffer, sizeof(buffer), "%H:%M:%S", &timeinfo);
  return String(buffer);
}

void updateIsabellaMood() {
  if (faceMode != FACE_IDLE && faceMode != FACE_HAPPY && faceMode != FACE_CURIOUS && faceMode != FACE_LAUGH && faceMode != FACE_SURPRISED) return;
  if (millis() < nextIsabellaMoodAt) return;

  const FaceMode moods[] = {FACE_HAPPY, FACE_CURIOUS, FACE_LAUGH, FACE_SURPRISED, FACE_IDLE};
  isabellaMood = moods[random(0, 5)];
  if (isabellaMood == FACE_IDLE) {
    faceMode = FACE_IDLE;
    lastEvent = "Isabella mood: soft idle";
  } else {
    faceMode = isabellaMood;
    lastEvent = "Isabella mood: " + faceName();
  }
  nextIsabellaMoodAt = millis() + random(ROCKY_ISABELLA_MOOD_MIN_MS, ROCKY_ISABELLA_MOOD_MAX_MS);
}

void setOledInverted(bool enabled, const String &reason) {
  oledInverted = enabled;
  preferences.putBool("oledInv", oledInverted);
  display.invertDisplay(oledInverted);
  lastEvent = reason + String(": ") + (oledInverted ? "on" : "off");
  Serial.println(lastEvent);
  drawFace();
}

void onOtaUiEvent(const char *state, int progress) {
  otaUiState = String(state);
  otaUiProgress = progress;
  if (otaUiState == "checking" || otaUiState == "update_available" || otaUiState == "downloading" || otaUiState == "installing" || otaUiState == "rebooting") {
    drawOtaIndicator();
  }
}

void drawOtaIndicator() {
  display.invertDisplay(oledInverted);
  display.clearDisplay();
  display.setTextColor(SSD1306_WHITE);
  display.setTextSize(1);
  display.setCursor(8, 8);
  display.print("Deskbot OTA");
  display.setCursor(8, 23);
  display.print(otaUiState);
  if (otaUiState == "downloading" || otaUiState == "installing") {
    display.print(" ");
    display.print(otaUiProgress);
    display.print("%");
  }
  display.drawRect(8, 40, 112, 10, SSD1306_WHITE);
  const int width = constrain((otaUiProgress * 108) / 100, 0, 108);
  if (width > 0) display.fillRect(10, 42, width, 6, SSD1306_WHITE);
  display.display();
}

void drawFace() {
  if (!display.width()) return;
  display.invertDisplay(oledInverted);
  display.clearDisplay();

  // The referenced desktop-pet OLED task keeps character identity separate
  // from state and hardware. Isabella and Spartan use those imported
  // character renderers; the other personalities keep the bring-up renderer.
  if (drawImportedCharacter()) {
    drawWiFiIndicator();
    drawMicIndicator();
    display.display();
    return;
  }

  drawWiFiIndicator();
  drawMicIndicator();

  if (faceMode == FACE_SLEEP) {
    display.setTextSize(2);
    display.setCursor(45, 26);
    display.print("- -");
    display.setTextSize(1);
    display.setCursor(43, 52);
    display.print("sleep");
    display.display();
    return;
  }

  int eyeY = 20;
  int eyeH = 20;
  bool narrow = faceMode == FACE_SAD || faceMode == FACE_WORKING || personality == PERSONALITY_SPARTAN;
  bool round = personality == PERSONALITY_ROCKY || personality == PERSONALITY_ISABELLA || faceMode == FACE_HAPPY || faceMode == FACE_LAUGH || faceMode == FACE_SURPRISED;
  bool lookingLeft = panAngle < 65;
  bool lookingRight = panAngle > 115;

  // Thinking and working are deliberately different visual states.
  if (faceMode == FACE_THINKING) {
    eyeH = 17;
    lookingRight = ((faceFrame / 8) % 2) == 0;
    lookingLeft = !lookingRight;
  }
  if (faceMode == FACE_WORKING) {
    eyeH = 14;
    lookingLeft = ((faceFrame / 5) % 2) == 0;
    lookingRight = !lookingLeft;
  }
  if (faceMode == FACE_CURIOUS) eyeH = 24;
  if (faceMode == FACE_SURPRISED) eyeH = 26;

  drawEyes(eyeY, eyeH, narrow, round, lookingLeft, lookingRight);
  drawPersonalityAccent();
  drawMouth();

  display.setTextSize(1);
  display.setCursor(2, 56);
  if (faceMode == FACE_LISTENING) display.print("listening");
  else if (faceMode == FACE_THINKING) display.print("thinking...");
  else if (faceMode == FACE_WORKING) display.print("executing...");
  else if (faceMode == FACE_SPEAKING) display.print("speaking");
  else if (faceMode == FACE_ERROR) display.print("check system");
  else if (personality == PERSONALITY_ISABELLA) display.print("isabella");
  else display.print(personalityName());
  display.display();
}

void drawEyes(int eyeY, int eyeH, bool narrow, bool round, bool lookingLeft, bool lookingRight) {
  int leftX = 19;
  int rightX = 75;
  int eyeW = 34;
  int actualH = narrow ? 13 : eyeH;
  if (personality == PERSONALITY_CALM) actualH = min(actualH, 13);
  if (personality == PERSONALITY_ROCKY) actualH = min(actualH, 18);
  if (personality == PERSONALITY_ISABELLA) actualH = max(actualH, 23);
  int y = eyeY + (eyeH - actualH) / 2;

  if (personality == PERSONALITY_CALM) {
    display.fillRoundRect(leftX, y, eyeW, actualH, 2, SSD1306_WHITE);
    display.fillRoundRect(rightX, y, eyeW, actualH, 2, SSD1306_WHITE);
  } else if (personality == PERSONALITY_ROCKY) {
    display.fillRect(leftX, y, eyeW, actualH, SSD1306_WHITE);
    display.fillRect(rightX, y, eyeW, actualH, SSD1306_WHITE);
  } else if (personality == PERSONALITY_ISABELLA) {
    display.fillRoundRect(leftX, y, eyeW, actualH, 10, SSD1306_WHITE);
    display.fillRoundRect(rightX, y, eyeW, actualH, 10, SSD1306_WHITE);
  } else if (round) {
    display.fillRoundRect(leftX, y, eyeW, actualH, 6, SSD1306_WHITE);
    display.fillRoundRect(rightX, y, eyeW, actualH, 6, SSD1306_WHITE);
  } else {
    display.fillRoundRect(leftX, y, eyeW, actualH, 3, SSD1306_WHITE);
    display.fillRoundRect(rightX, y, eyeW, actualH, 3, SSD1306_WHITE);
  }

  int pupilShift = lookingLeft ? -7 : (lookingRight ? 7 : 0);
  if (faceMode == FACE_LISTENING) pupilShift = ((faceFrame / 5) % 2 == 0) ? -2 : 2;
  if (faceMode == FACE_SPEAKING) pupilShift = ((faceFrame / 4) % 2 == 0) ? -1 : 1;
  if (faceMode == FACE_WORKING) pupilShift = ((faceFrame / 3) % 2 == 0) ? -5 : 5;
  int pupilRadius = personality == PERSONALITY_ISABELLA ? 4 : (personality == PERSONALITY_ROCKY ? 2 : 3);
  display.fillCircle(leftX + eyeW / 2 + pupilShift, y + actualH / 2, pupilRadius, SSD1306_BLACK);
  display.fillCircle(rightX + eyeW / 2 + pupilShift, y + actualH / 2, pupilRadius, SSD1306_BLACK);
  if (personality == PERSONALITY_ISABELLA) {
    display.drawPixel(leftX + eyeW / 2 + pupilShift - 1, y + actualH / 2 - 1, SSD1306_WHITE);
    display.drawPixel(rightX + eyeW / 2 + pupilShift - 1, y + actualH / 2 - 1, SSD1306_WHITE);
  }

  if ((faceFrame % (personality == PERSONALITY_ISABELLA ? 47 : 83)) == 0 && (faceMode == FACE_IDLE || personality == PERSONALITY_ISABELLA)) {
    display.fillRect(leftX, eyeY + eyeH / 2 - 1, eyeW, 3, SSD1306_BLACK);
    display.fillRect(rightX, eyeY + eyeH / 2 - 1, eyeW, 3, SSD1306_BLACK);
  }
}

void drawPersonalityAccent() {
  if (personality == PERSONALITY_CALM) {
    display.drawLine(21, 15, 45, 13, SSD1306_WHITE);
    display.drawLine(83, 13, 107, 15, SSD1306_WHITE);
    display.drawPixel(10, 11, SSD1306_WHITE);
  } else if (personality == PERSONALITY_ROCKY) {
    display.drawLine(19, 14, 47, 10, SSD1306_WHITE);
    display.drawLine(81, 10, 109, 14, SSD1306_WHITE);
    display.drawCircle(8, 9, 3, SSD1306_WHITE);
    display.drawLine(8, 6, 8, 2, SSD1306_WHITE);
  } else if (personality == PERSONALITY_ENGINEER) {
    display.drawRect(14, 17, 43, 27, SSD1306_WHITE);
    display.drawRect(71, 17, 43, 27, SSD1306_WHITE);
    display.drawLine(57, 28, 71, 28, SSD1306_WHITE);
    display.drawLine(47, 11, 51, 6, SSD1306_WHITE);
    display.drawLine(51, 8, 57, 5, SSD1306_WHITE);
  } else if (personality == PERSONALITY_SPARTAN) {
    display.drawLine(47, 14, 64, 7, SSD1306_WHITE);
    display.drawLine(64, 7, 81, 14, SSD1306_WHITE);
    display.drawLine(16, 42, 29, 47, SSD1306_WHITE);
    display.drawLine(112, 42, 99, 47, SSD1306_WHITE);
  } else if (personality == PERSONALITY_ISABELLA) {
    // Soft animated Isabella cue: bow, sparkles, and a gentle center highlight.
    display.drawLine(6, 14, 6, 6, SSD1306_WHITE);
    display.drawLine(2, 10, 10, 10, SSD1306_WHITE);
    display.drawLine(116, 14, 116, 6, SSD1306_WHITE);
    display.drawLine(112, 10, 120, 10, SSD1306_WHITE);
    display.drawCircle(64, 11, 3, SSD1306_WHITE);
    display.drawLine(61, 11, 57, 7, SSD1306_WHITE);
    display.drawLine(67, 11, 71, 7, SSD1306_WHITE);
  }
}

void drawMouth() {
  int y = 48;
  bool animate = (faceMode == FACE_SPEAKING || faceMode == FACE_LAUGH);
  if (faceMode == FACE_SAD || faceMode == FACE_ERROR) {
    display.drawLine(54, y + 4, 64, y, SSD1306_WHITE);
    display.drawLine(64, y, 74, y + 4, SSD1306_WHITE);
    return;
  }
  if (faceMode == FACE_SURPRISED) {
    display.drawCircle(64, y + 2, 6, SSD1306_WHITE);
    return;
  }
  if (faceMode == FACE_HAPPY || faceMode == FACE_LAUGH) {
    display.drawLine(51, y, 58, y + 5, SSD1306_WHITE);
    display.drawLine(58, y + 5, 70, y + 5, SSD1306_WHITE);
    display.drawLine(70, y + 5, 77, y, SSD1306_WHITE);
    if (faceMode == FACE_LAUGH) display.drawLine(57, y + 8, 71, y + 8, SSD1306_WHITE);
    return;
  }
  if (faceMode == FACE_THINKING) {
    display.fillCircle(57, y + 3, 2, SSD1306_WHITE);
    display.fillCircle(64, y + 3, 2, SSD1306_WHITE);
    display.fillCircle(71, y + 3, 2, SSD1306_WHITE);
    return;
  }
  if (faceMode == FACE_WORKING) {
    display.drawLine(54, y + 3, 74, y + 3, SSD1306_WHITE);
    display.drawLine(58, y + 6, 70, y + 6, SSD1306_WHITE);
    return;
  }
  if (animate && ((faceFrame / 3) % 3 == 0)) {
    display.fillRoundRect(54, y - 2, 20, 11, 4, SSD1306_WHITE);
    display.drawLine(58, y + 3, 70, y + 3, SSD1306_BLACK);
  } else if (faceMode == FACE_LISTENING) {
    display.drawCircle(64, y + 2, 5, SSD1306_WHITE);
  } else if (faceMode == FACE_CURIOUS) {
    display.drawLine(55, y + 3, 73, y + 3, SSD1306_WHITE);
  } else if (personality == PERSONALITY_ISABELLA && ((faceFrame / 4) % 2 == 0)) {
    display.drawLine(51, y, 58, y + 5, SSD1306_WHITE);
    display.drawLine(58, y + 5, 70, y + 5, SSD1306_WHITE);
    display.drawLine(70, y + 5, 77, y, SSD1306_WHITE);
  } else if (personality == PERSONALITY_CALM) {
    display.drawLine(57, y + 3, 71, y + 3, SSD1306_WHITE);
  } else if (personality == PERSONALITY_ROCKY) {
    display.drawLine(53, y + 1, 59, y + 4, SSD1306_WHITE);
    display.drawLine(59, y + 4, 69, y + 4, SSD1306_WHITE);
    display.drawLine(69, y + 4, 75, y + 1, SSD1306_WHITE);
  } else {
    display.drawLine(55, y + 2, 73, y + 2, SSD1306_WHITE);
  }
}

void drawMicIndicator() {
  if (!microphoneMonitor && !microphoneLoopback) return;
  display.drawRect(2, 2, 30, 6, SSD1306_WHITE);
  int width = constrain((microphoneLevel * 26) / 99, 0, 26);
  if (width > 0) display.fillRect(4, 4, width, 2, SSD1306_WHITE);
  if (microphoneLoopback) display.drawCircle(37, 5, 3, SSD1306_WHITE);
}

void drawWiFiIndicator() {
  int x = 110;
  int y = 2;
  if (provisioningAP) {
    display.drawRect(x, y, 12, 9, SSD1306_WHITE);
    display.drawPixel(x + 3, y + 4, SSD1306_WHITE);
    display.drawPixel(x + 8, y + 4, SSD1306_WHITE);
    return;
  }
  if (WiFi.status() == WL_CONNECTED) {
    display.fillCircle(x + 6, y + 8, 2, SSD1306_WHITE);
    display.drawLine(x + 2, y + 5, x + 4, y + 3, SSD1306_WHITE);
    display.drawLine(x + 8, y + 3, x + 10, y + 5, SSD1306_WHITE);
    display.drawLine(x, y + 2, x + 3, y, SSD1306_WHITE);
    display.drawLine(x + 9, y, x + 12, y + 2, SSD1306_WHITE);
  } else {
    display.drawLine(x, y, x + 12, y + 10, SSD1306_WHITE);
    display.drawLine(x + 12, y, x, y + 10, SSD1306_WHITE);
  }
}

// End of modular XIAO bring-up firmware.
// Voice, speaker playback, wake-word, and LLM modules remain separate next
// stages; camera, microphone level monitoring, dashboard, and OTA are present.
