MrunalSwaroop/deskbot/versions/v0.0.5.4/source/firmware/xiao_esp32s3_sense/ota_pages_root_ca.h

#pragma once

// ISRG Root X1, used by GitHub Pages' Let's Encrypt certificate chain.
// This is a public CA certificate, not a secret.
static const char pages_root_ca[] PROGMEM = R"EOF(
-----BEGIN CERTIFICATE-----
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
-----END CERTIFICATE-----
)EOF";
