MrunalSwaroop/deskbot/versions/v0.0.5.4/source/firmware/xiao_esp32s3_sense/ota_target.example.h

#pragma once

// Copy this file to ota_target.h only after the deskbot GitHub Pages workflow is ready.
// Keep ota_target.h local and ignored.
#define ROCKY_OTA_ENABLED 1
#define APP_VERSION "0.0.5.2-ota-bootstrap"
#define OTA_UPDATE_URL "https://MrunalSwaroop.github.io/deskbot/ota/XIAO-ESP32S3.bin"
#define OTA_MANIFEST_URL "https://MrunalSwaroop.github.io/deskbot/ota/xiao-esp32s3-manifest.json"
#define OTA_MANIFEST_HOST "MrunalSwaroop.github.io"
#define OTA_MANIFEST_PATH "/deskbot/ota/xiao-esp32s3-manifest.json"
#define OTA_CATALOG_URL "https://MrunalSwaroop.github.io/deskbot/ota/catalog.json"
#define OTA_TARGET_VERSION ""
