MrunalSwaroop/deskbot/(commit log)

2026-09-27 Freeze Deskbot v0.0.1 hardware baseline
    [partitions.csv]
2026-09-27 Fix XIAO OTA build settings after 0.0.2 boot failure
    [check_release.py]
2026-09-28 Match OTA build to working ESP32 core 3.3.7
2026-10-03 Add browsable version folders and correct OTA catalog metadata
    [check_release.py, device_config.h, face_renderer.h]
